RomanLut/Multiwii-ESP32-port/doc/gps_code/gps_code.md

# Abandoned: GPS and compass support

Wiring which has been used in original tests:

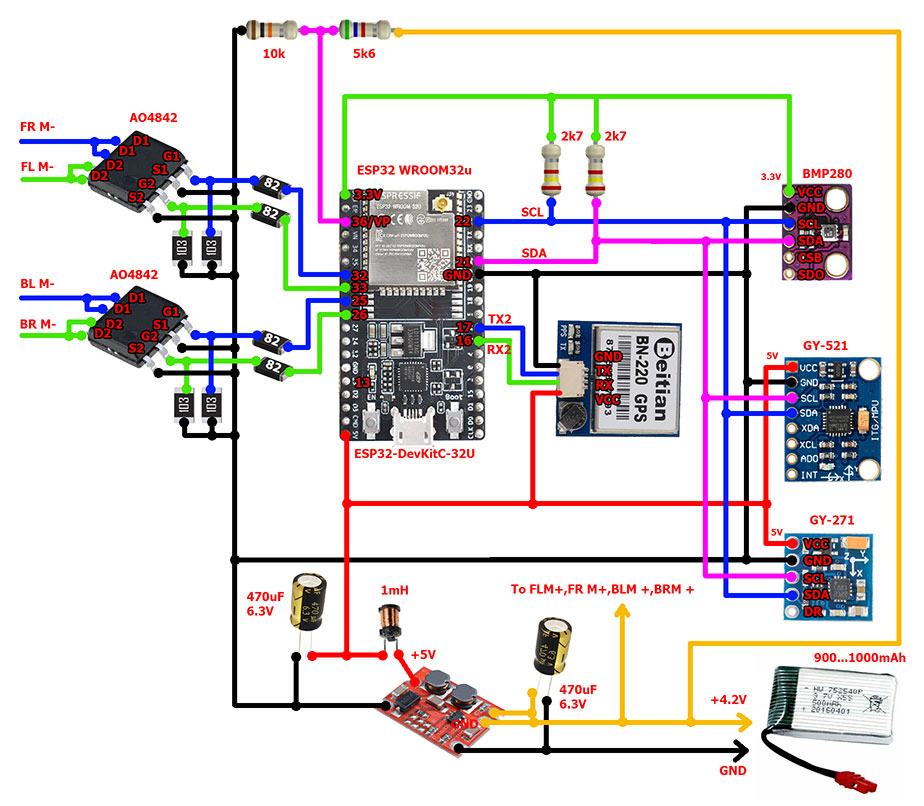
[picture p13: doc/gps_code/wiring.jpg]
wiring


Magnetometer calibration
=========================
Should be done once of each new location
Yaw right + Throttle Hi + Pitch Low
Red and blue leds are blining in circle pattern

At least 30 seconds of calibration.
Rotate quad in all directions. If you do not hear beeps anymore, try another direction of rotation.
Calibration ends when no beeps are heard for 10 seconds.
