RomanLut/Multiwii-ESP32-port/doc/preview.png

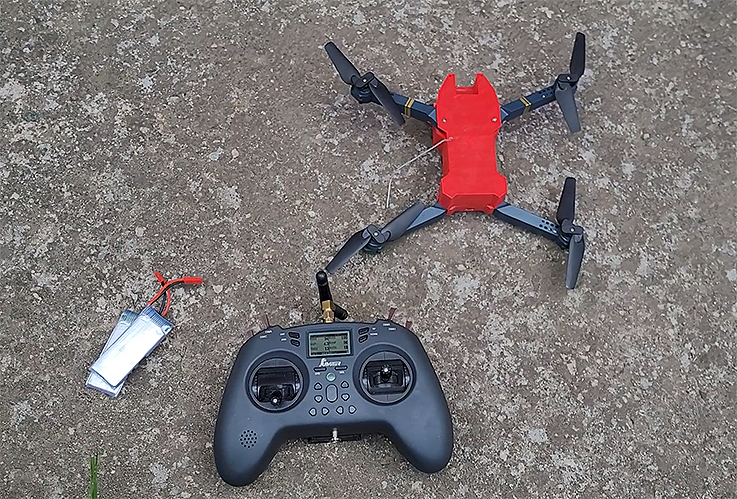
doc/preview.png
