RomanLut/Multiwii-ESP32-port/doc/reference/bmp280.jpg

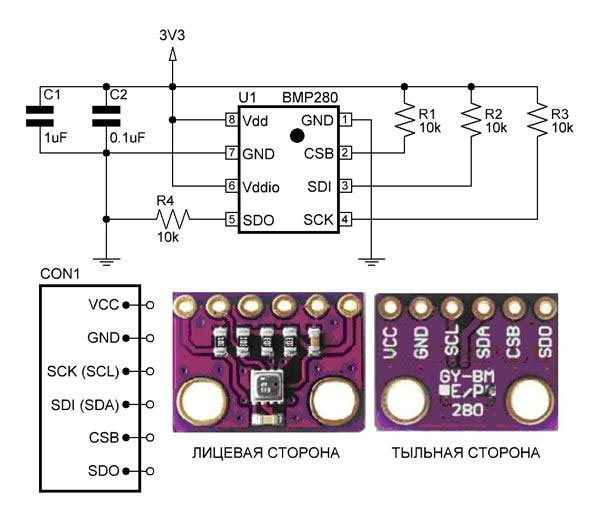
doc/reference/bmp280.jpg
