RomanLut/Multiwii-ESP32-port/doc/reference/esp32_devkitc_wroom32_pinout.jpg

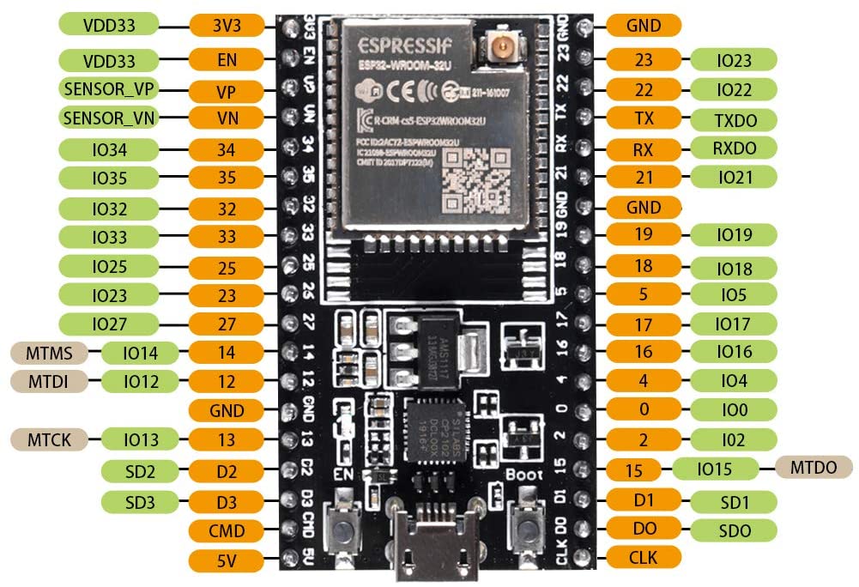
doc/reference/esp32_devkitc_wroom32_pinout.jpg
