RomanLut/Multiwii-ESP32-port/doc/reference/GY521.jpg

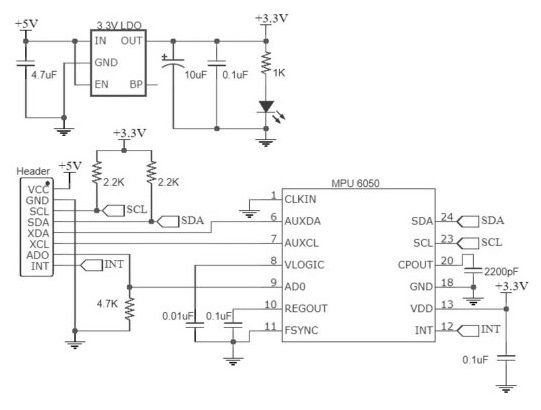
doc/reference/GY521.jpg
