RomanLut/Multiwii-ESP32-port/Drawings/IMG_1333.jpg

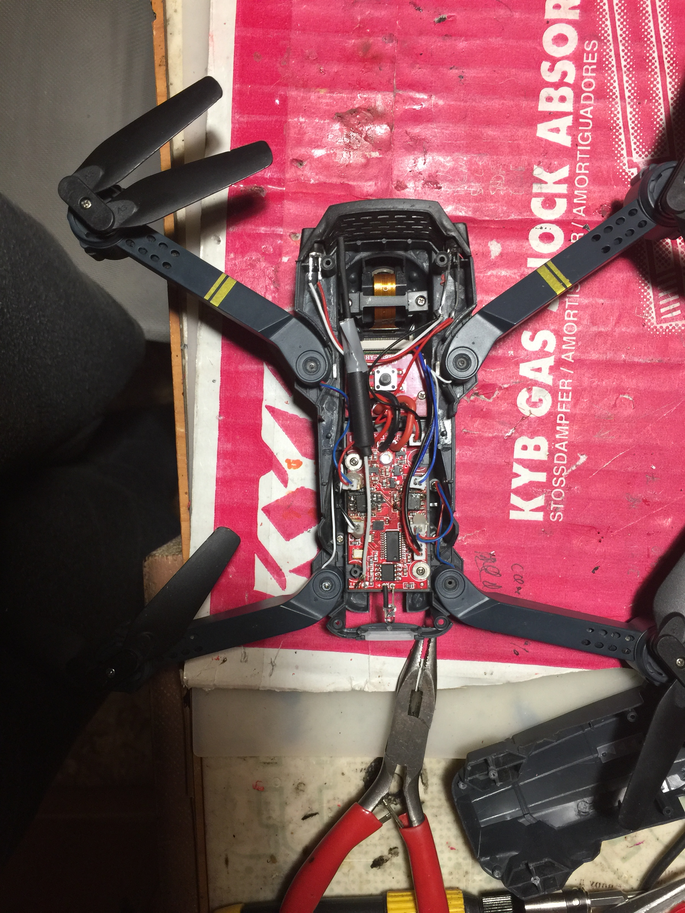
Drawings/IMG_1333.jpg
