RomanLut/Multiwii-ESP32-port/Drawings/quad.SLDASM

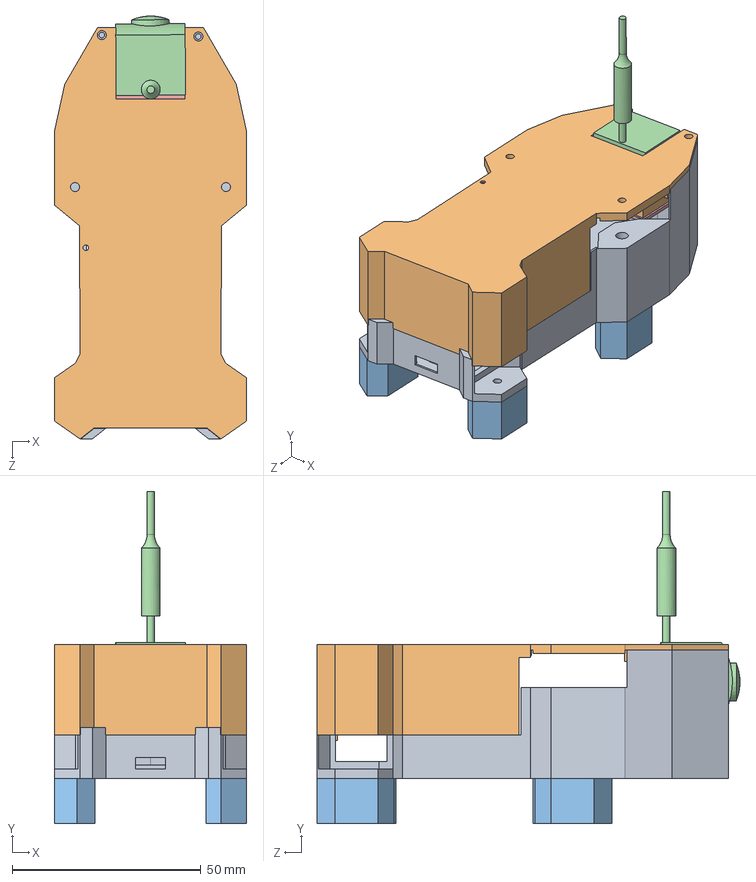
[picture p19: CAD file, 2022-08-13]
Drawings/quad.SLDASM
50.9 x 88.0 x 112.1 mm
Bottom
top
leg x 4
camera_aio
camera_bottom
