RomanLut/Multiwii-ESP32-port/Drawings/top.sldprt

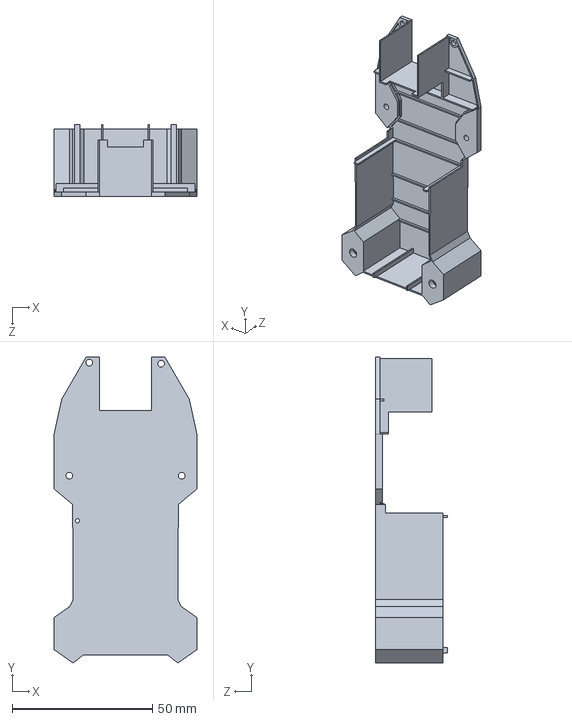
[picture p20: CAD file, 2022-08-13]
Drawings/top.sldprt
50.9 x 109.0 x 25.5 mm
