RomanLut/Multiwii-ESP32-port/Drawings/inset.SLDPRT

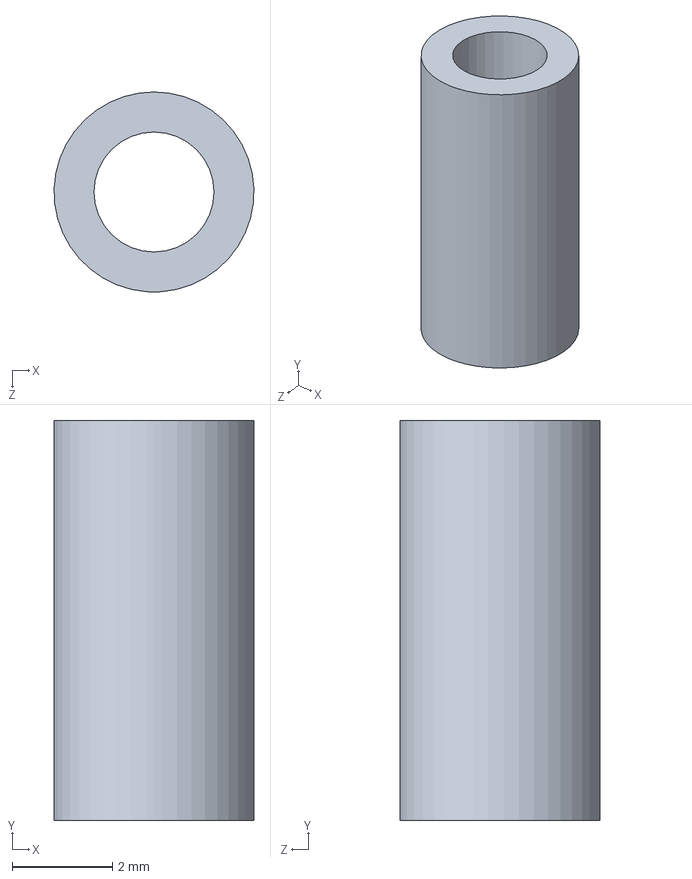
[picture p21: CAD file, 2022-08-13]
Drawings/inset.SLDPRT
4.00 x 8.00 x 4.00 mm
