RomanLut/Multiwii-ESP32-port/Drawings/leg.sldprt

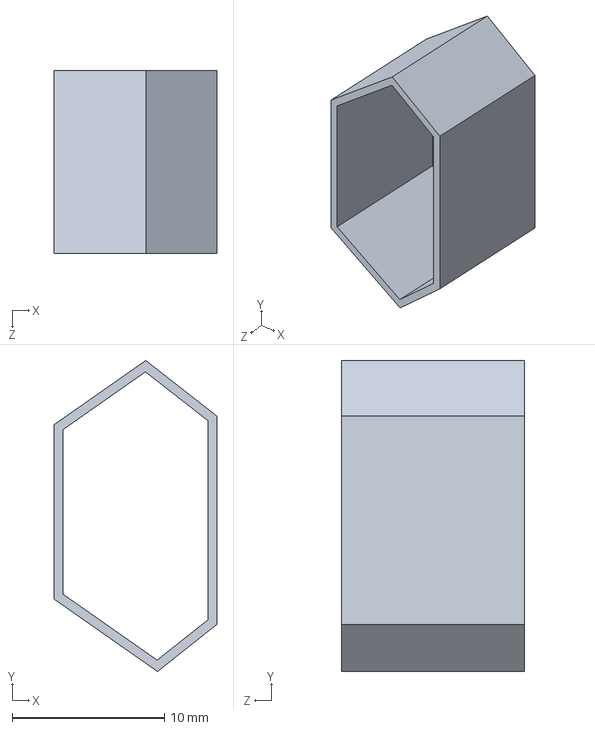
[picture p22: CAD file, 2022-08-13]
Drawings/leg.sldprt
10.7 x 20.4 x 12.0 mm
