RomanLut/Multiwii-ESP32-port/Drawings/ledcap.SLDPRT

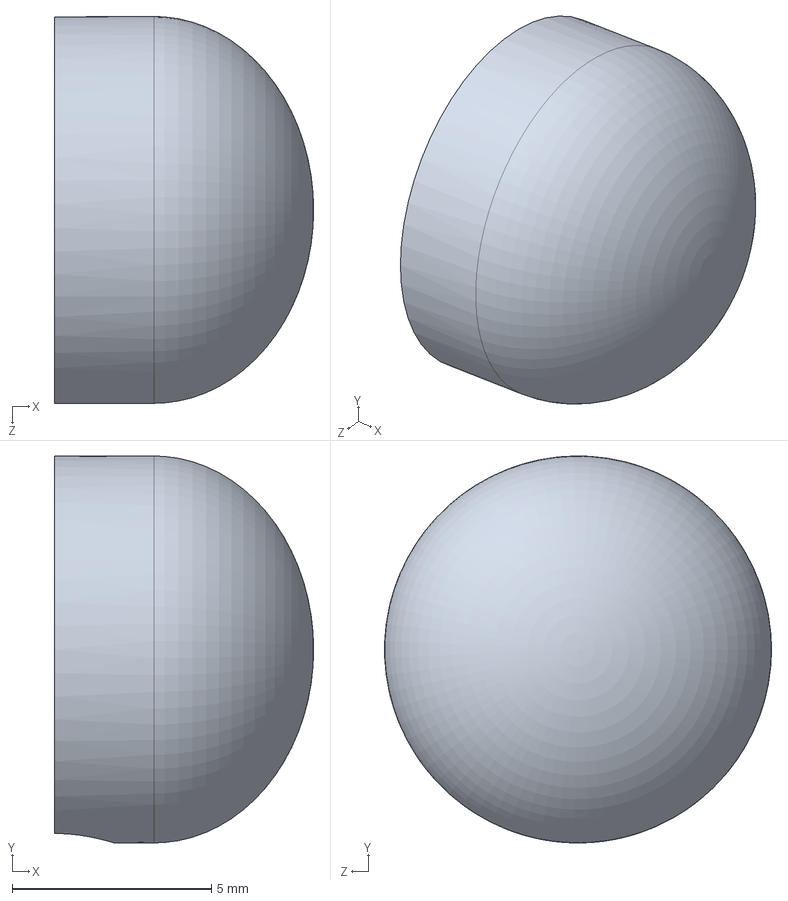
[picture p23: CAD file, 2022-08-13]
Drawings/ledcap.SLDPRT
6.50 x 9.70 x 9.70 mm
