RomanLut/Multiwii-ESP32-port/Drawings/camera_bottom.SLDPRT

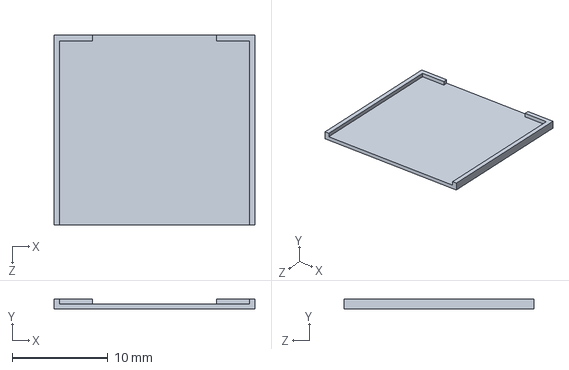
[picture p24: CAD file, 2022-08-13]
Drawings/camera_bottom.SLDPRT
21.0 x 1.00 x 19.8 mm
