RomanLut/Multiwii-ESP32-port/Drawings/camera_aio.SLDPRT

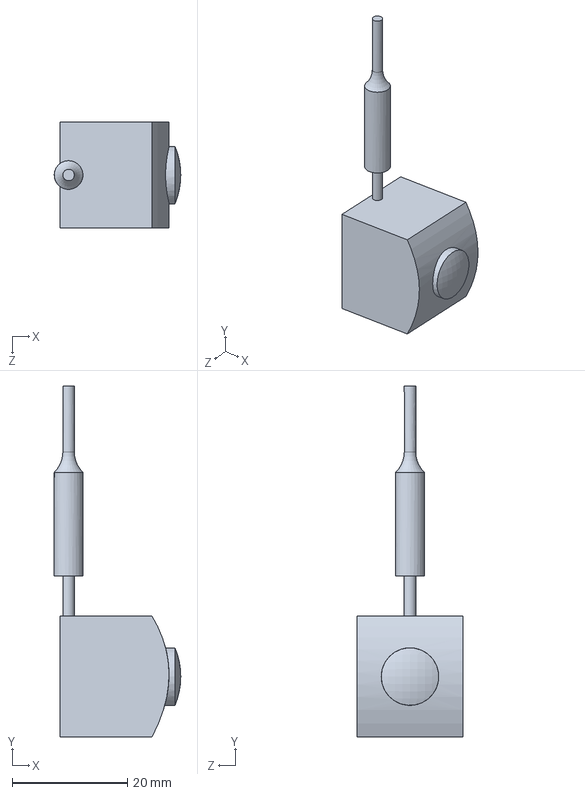
[picture p25: CAD file, 2022-08-13]
Drawings/camera_aio.SLDPRT
22.0 x 61.0 x 18.4 mm
