RomanLut/Multiwii-ESP32-port/Drawings/Bottom.STL

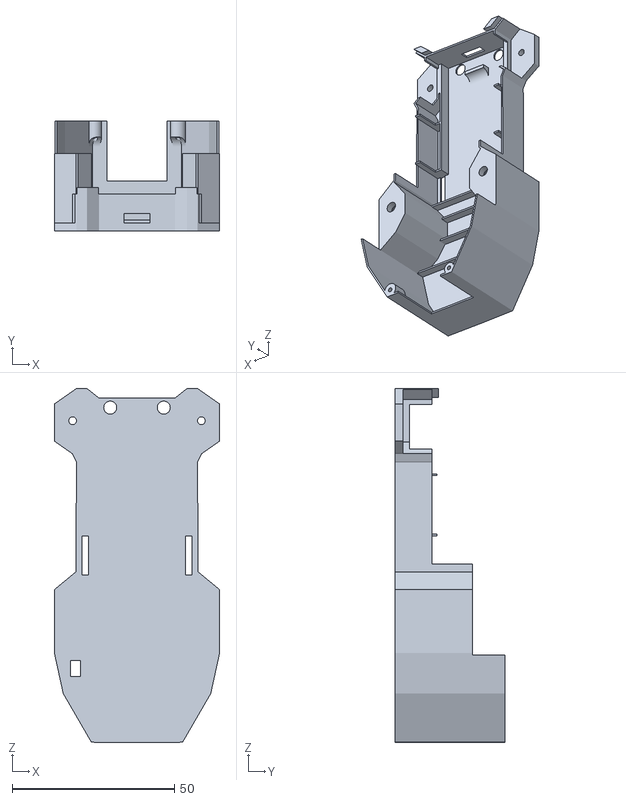
[picture p26: CAD file, 2022-08-13]
Drawings/Bottom.STL
50.9 x 34.0 x 109.1
