RomanLut/Multiwii-ESP32-port/(list of files, cad)

Other CAD files:
Drawings/camera_bottom.STL
Drawings/inset.STL
Drawings/ledcap.STL
Drawings/leg.STL
Drawings/top.STL
