RomanLut/Multiwii-ESP32-port/PlatformIO/src/Sensors.cpp

#ifdef ESP32
#include <Wire.h>
#endif 

#include "Arduino.h"
#include "config.h"
#include "def.h"
#include "types.h"
#include "MahoWii.h"
#include "Alarms.h"
#include "myEEPROM.h"
#include "IMU.h"
#include "LCD.h"
#include "Sensors.h"
#include "AltHold.h"

uint32_t magBeep;

static void Device_Mag_getADC();
static void Baro_init();
static void Mag_init();
static void ACC_init();

// ************************************************************************************************************
// board orientation and setup
// ************************************************************************************************************
//default board orientation
#if !defined(ACC_ORIENTATION)
  #define ACC_ORIENTATION(X, Y, Z)  {imu.accADC[ROLL]  = X; imu.accADC[PITCH]  = Y; imu.accADC[YAW]  = Z;}
#endif
#if !defined(GYRO_ORIENTATION)
  #define GYRO_ORIENTATION(X, Y, Z) {imu.gyroADC[ROLL] = X; imu.gyroADC[PITCH] = Y; imu.gyroADC[YAW] = Z;}
#endif
#if !defined(MAG_ORIENTATION)
  #define MAG_ORIENTATION(X, Y, Z)  {imu.magADC[ROLL]  = X; imu.magADC[PITCH]  = Y; imu.magADC[YAW]  = Z;}
#endif


//ITG3200 / ITG3205 / ITG3050 / MPU6050 / MPU3050 Gyro LPF setting
#if defined(GYRO_LPF_256HZ) || defined(GYRO_LPF_188HZ) || defined(GYRO_LPF_98HZ) || defined(GYRO_LPF_42HZ) || defined(GYRO_LPF_20HZ) || defined(GYRO_LPF_10HZ) || defined(GYRO_LPF_5HZ)
  #if defined(GYRO_LPF_256HZ)
    #define GYRO_DLPF_CFG   0
  #endif
  #if defined(GYRO_LPF_188HZ)
    #define GYRO_DLPF_CFG   1
  #endif
  #if defined(GYRO_LPF_98HZ)
    #define GYRO_DLPF_CFG   2
  #endif
  #if defined(GYRO_LPF_42HZ)
    #define GYRO_DLPF_CFG   3
  #endif
  #if defined(GYRO_LPF_20HZ)
    #define GYRO_DLPF_CFG   4
  #endif
  #if defined(GYRO_LPF_10HZ)
    #define GYRO_DLPF_CFG   5
  #endif
  #if defined(GYRO_LPF_5HZ)
    #define GYRO_DLPF_CFG   6
  #endif
#else
    #define GYRO_DLPF_CFG   4 //Default settings LPF 20HZ
#endif

static uint8_t rawADC[6];
#if defined(WMP)
static uint32_t neutralizeTime = 0;
#endif

// ************************************************************************************************************
// I2C general functions
// ************************************************************************************************************

void i2c_init(void) {
#ifndef ESP32
    #if defined(INTERNAL_I2C_PULLUPS)
      I2C_PULLUPS_ENABLE
    #else
      I2C_PULLUPS_DISABLE
    #endif
    TWSR = 0;                                    // no prescaler => prescaler = 1
    TWBR = ((F_CPU / 400000) - 16) / 2;          // set the I2C clock rate to 400kHz
    TWCR = 1<<TWEN;                              // enable twi module, no interrupt
 #else
      Wire.begin(); //on default pins 21,22
      Wire.setClock(400000);
#endif;
  i2c_errors_count = 0;
}

#ifndef ESP32
void __attribute__ ((noinline)) waitTransmissionI2C(uint8_t twcr) {
  TWCR = twcr;
  uint8_t count = 255;
  while (!(TWCR & (1<<TWINT))) {
    count--;
    if (count==0) {              //we are in a blocking state => we don't insist
      TWCR = 0;                  //and we force a reset on TWINT register
      #if defined(WMP)
      neutralizeTime = micros(); //we take a timestamp here to neutralize the value during a short delay
      #endif
      i2c_errors_count++;
      break;
    }
  }
}

void i2c_rep_start(uint8_t address) {
  waitTransmissionI2C((1<<TWINT) | (1<<TWSTA) | (1<<TWEN)); // send REPEAT START condition and wait until transmission completed
  TWDR = address;                                           // send device address
  waitTransmissionI2C((1<<TWINT) | (1<<TWEN));              // wail until transmission completed
}

void i2c_stop(void) {
  TWCR = (1 << TWINT) | (1 << TWEN) | (1 << TWSTO);
  //  while(TWCR & (1<<TWSTO));                // <- can produce a blocking state with some WMP clones
}

void i2c_write(uint8_t data ) {
  TWDR = data;                                 // send data to the previously addressed device
  waitTransmissionI2C((1<<TWINT) | (1<<TWEN));
}

uint8_t i2c_readAck() {
  waitTransmissionI2C((1<<TWINT) | (1<<TWEN) | (1<<TWEA));
  return TWDR;
}

uint8_t i2c_readNak() {
  waitTransmissionI2C((1<<TWINT) | (1<<TWEN));
  uint8_t r = TWDR;
  i2c_stop();
  return r;
}
#endif

void i2c_read_reg_to_buf(uint8_t add, uint8_t reg, uint8_t *buf, uint8_t size) {
#ifndef ESP32
  i2c_rep_start(add<<1); // I2C write direction
  i2c_write(reg);        // register selection
  i2c_rep_start((add<<1) | 1);  // I2C read direction
  uint8_t *b = buf;
  while (--size) *b++ = i2c_readAck(); // acknowledge all but the final byte
  *b = i2c_readNak();
#else
  Wire.beginTransmission(add);
  Wire.write(reg); 
  int error = Wire.endTransmission(false);
  if ( error != 0 ) i2c_errors_count++;
  int count = Wire.requestFrom((uint16_t)add, size, true);
  if (count != size)
  {
    i2c_errors_count++;
  }
  uint8_t *b = buf;
  if ( count ) while (count-- && size--) *b++ = Wire.read();
#endif
}

void i2c_getSixRawADC(uint8_t add, uint8_t reg) {
  i2c_read_reg_to_buf(add, reg, rawADC, 6);
}

void i2c_writeReg(uint8_t add, uint8_t reg, uint8_t val) {
#ifndef ESP32
  i2c_rep_start(add<<1); // I2C write direction
  i2c_write(reg);        // register selection
  i2c_write(val);        // value to write in register
  i2c_stop();
#else
  Wire.beginTransmission(add);
  Wire.write(reg);
  Wire.write(val);
  int error = Wire.endTransmission(true);
  if (error != 0) i2c_errors_count++;
#endif
}

uint8_t i2c_readReg(uint8_t add, uint8_t reg) {
  uint8_t val;
  i2c_read_reg_to_buf(add, reg, &val, 1);
  return val;
}

// ****************
// GYRO common part
// ****************
void GYRO_Common() {
  static int16_t previousGyroADC[3] = {0,0,0};
  static int32_t g[3];
  uint8_t axis, tilt=0;

  #if defined MMGYRO
    // Moving Average Gyros by Magnetron1
    //---------------------------------------------------
    static int16_t mediaMobileGyroADC[3][MMGYROVECTORLENGTH];
    static int32_t mediaMobileGyroADCSum[3];
    static uint8_t mediaMobileGyroIDX;
    //---------------------------------------------------
  #endif

  if ( calibratingG == 512)
  {
    Serial.println("Calibrating gyro");
  }

	if (calibratingG > 0) {
		for (axis = 0; axis < 3; axis++) {
			if (calibratingG == 512) { // Reset g[axis] at start of calibration
				g[axis] = 0;
#if defined(GYROCALIBRATIONFAILSAFE)
				previousGyroADC[axis] = imu.gyroADC[axis];
			}
			if (calibratingG % 10 == 0) {
				if (abs(imu.gyroADC[axis] - previousGyroADC[axis]) > 8) {
					tilt = 1;
				}
				previousGyroADC[axis] = imu.gyroADC[axis];
#endif
			}
			g[axis] += imu.gyroADC[axis]; // Sum up 512 readings
			//gyroZero[axis] = g[axis] >> 9;
			gyroZero[axis] = g[axis] >> 5; // increase gyro bias precision to 2^(9-5)=16 times
			if (calibratingG == 1) {
				SET_ALARM_BUZZER(ALRM_FAC_CONFIRM, ALRM_LVL_CONFIRM_ELSE);
			}
		}
#if defined(GYROCALIBRATIONFAILSAFE)
		if (tilt) {
			calibratingG = 1000;
      Serial.println("Calibrating gyro failed");
			LEDPIN_ON;
		} else {
			calibratingG--;
      if (calibratingG == 0)
      {
        Serial.println("Calibrating gyro done");
      }
			LEDPIN_OFF;
		}
		return;
#else
		calibratingG--;
#endif
	}

  #ifdef MMGYRO
  mediaMobileGyroIDX = ++mediaMobileGyroIDX % conf.mmgyro;
  for (axis = 0; axis < 3; axis++) {
    //imu.gyroADC[axis]  -= gyroZero[axis];
    imu.gyroADC[axis] = ( (((int32_t)imu.gyroADC[axis]) << 4) - gyroZero[axis]) >> 4; // increase gyro bias precision to 2^(9-5)=16 times
    mediaMobileGyroADCSum[axis] -= mediaMobileGyroADC[axis][mediaMobileGyroIDX];
    //anti gyro glitch, limit the variation between two consecutive readings
    mediaMobileGyroADC[axis][mediaMobileGyroIDX] = constrain(imu.gyroADC[axis],previousGyroADC[axis]-800,previousGyroADC[axis]+800);
    mediaMobileGyroADCSum[axis] += mediaMobileGyroADC[axis][mediaMobileGyroIDX];
    imu.gyroADC[axis] = mediaMobileGyroADCSum[axis] / conf.mmgyro;
  #else
  for (axis = 0; axis < 3; axis++) {
    //imu.gyroADC[axis]  -= gyroZero[axis];
    imu.gyroADC[axis] = ( (((int32_t)imu.gyroADC[axis]) << 4) - gyroZero[axis]) >> 4; // increase gyro bias precision to 2^(9-5)=16 times

    //anti gyro glitch, limit the variation between two consecutive readings
    imu.gyroADC[axis] = constrain(imu.gyroADC[axis],previousGyroADC[axis]-800,previousGyroADC[axis]+800);
  #endif
    previousGyroADC[axis] = imu.gyroADC[axis];
  }

  #if defined(SENSORS_TILT_45DEG_LEFT)
    int16_t temp  = ((imu.gyroADC[PITCH] - imu.gyroADC[ROLL] )*7)/10;
    imu.gyroADC[ROLL] = ((imu.gyroADC[ROLL]  + imu.gyroADC[PITCH])*7)/10;
    imu.gyroADC[PITCH]= temp;
  #endif
  #if defined(SENSORS_TILT_45DEG_RIGHT)
    int16_t temp  = ((imu.gyroADC[PITCH] + imu.gyroADC[ROLL] )*7)/10;
    imu.gyroADC[ROLL] = ((imu.gyroADC[ROLL]  - imu.gyroADC[PITCH])*7)/10;
    imu.gyroADC[PITCH]= temp;
  #endif
}

// ****************
// ACC common part
// ****************
void ACC_Common() {
  static int32_t a[3];
  static uint8_t curAxis = YAW;
  static int16_t limits[3][2] = { {0,0}, {0,0}, {0,0} };

  if (calibratingA > 0) {
        for (uint8_t axis = 0; axis < 3; axis++) {
            // Reset a[axis] at start of calibration
            if (calibratingA == 512) {
                // Find which axis to calibrate?
                int8_t axis2 = (axis + 1) % 3;
                int8_t axis3 = (axis + 2) % 3;
                if ( abs(imu.accADC[axis] - global_conf.accZero[axis]) > abs(imu.accADC[axis2] - global_conf.accZero[axis2])
                		&& abs(imu.accADC[axis] - global_conf.accZero[axis]) > abs(imu.accADC[axis3] - global_conf.accZero[axis3])) {
                    curAxis = axis;
                    global_conf.accZero[curAxis] = 0;
                    global_conf.accScale[curAxis] = 0; // re-calibrate scale, too
                }

                a[axis] = 0;
            }

            // Sum up 512 readings
            a[axis] += imu.accADC[axis];
        }

        // Clear global variables for next reading and indicate curAxis in GUI by set to zero during calibration
        imu.accADC[curAxis] = 0;

        // Calculate average, shift Z down by acc_1G and store values in EEPROM at end of calibration
        if (calibratingA == 1) {
            int8_t curLimit = a[curAxis] > 0 ? 0 : 1; // positive - 0, negative = 1
            limits[curAxis][curLimit] = a[curAxis] >> 9;

            // If we get 2 limits for one axis, we can found precise zero and scale
            if (limits[curAxis][0] > 0 && limits[curAxis][1] < 0) {
                global_conf.accZero[curAxis] = (limits[curAxis][0] + limits[curAxis][1]) / 2;
                global_conf.accScale[curAxis] = ((int32_t) ACC_1G) * 2048 / (limits[curAxis][0] - limits[curAxis][1]);
            }
            // Old (not precise) calibration for Z only
            else if (curAxis == YAW && curLimit == 0) {
                for (uint8_t axis = 0; axis < 3; axis++) {
                    global_conf.accZero[axis] = a[axis] >> 9;
                    if (axis == YAW) {
                        global_conf.accZero[axis] -= ACC_1G;
                    }
                    global_conf.accScale[axis] = 0;
                }
            }

            conf.angleTrim[ROLL] = 0;
            conf.angleTrim[PITCH] = 0;
            writeGlobalSet(1); // write accZero in EEPROM
        }
        calibratingA--;
    }

  /*if (calibratingA>0) {
    calibratingA--;
    for (uint8_t axis = 0; axis < 3; axis++) {
      if (calibratingA == 511) a[axis]=0;   // Reset a[axis] at start of calibration
      a[axis] +=imu.accADC[axis];           // Sum up 512 readings
      global_conf.accZero[axis] = a[axis]>>9; // Calculate average, only the last itteration where (calibratingA == 0) is relevant
    }
    if (calibratingA == 0) {
      global_conf.accZero[YAW] -= ACC_1G;   // shift Z down by ACC_1G and store values in EEPROM at end of calibration
      conf.angleTrim[ROLL]   = 0;
      conf.angleTrim[PITCH]  = 0;
      writeGlobalSet(1); // write accZero in EEPROM
    }
  }*/

  #if defined(INFLIGHT_ACC_CALIBRATION)
      static int32_t b[3];
      static int16_t accZero_saved[3]  = {0,0,0};
      static int16_t  angleTrim_saved[2] = {0, 0};
      //Saving old zeropoints before measurement
      if (InflightcalibratingA==50) {
         accZero_saved[ROLL]  = global_conf.accZero[ROLL] ;
         accZero_saved[PITCH] = global_conf.accZero[PITCH];
         accZero_saved[YAW]   = global_conf.accZero[YAW] ;
         angleTrim_saved[ROLL]  = conf.angleTrim[ROLL] ;
         angleTrim_saved[PITCH] = conf.angleTrim[PITCH] ;
      }
      if (InflightcalibratingA>0) {
        for (uint8_t axis = 0; axis < 3; axis++) {
          // Reset a[axis] at start of calibration
          if (InflightcalibratingA == 50) b[axis]=0;
          // Sum up 50 readings
          b[axis] +=imu.accADC[axis];
          // Clear global variables for next reading
          imu.accADC[axis]=0;
          global_conf.accZero[axis]=0;
        }
        //all values are measured
        if (InflightcalibratingA == 1) {
          AccInflightCalibrationActive = 0;
          AccInflightCalibrationMeasurementDone = 1;
          SET_ALARM_BUZZER(ALRM_FAC_CONFIRM, ALRM_LVL_CONFIRM_1);     //buzzer for indicatiing the end of calibration
          // recover saved values to maintain current flight behavior until new values are transferred
          global_conf.accZero[ROLL]  = accZero_saved[ROLL] ;
          global_conf.accZero[PITCH] = accZero_saved[PITCH];
          global_conf.accZero[YAW]   = accZero_saved[YAW] ;
          conf.angleTrim[ROLL]  = angleTrim_saved[ROLL] ;
          conf.angleTrim[PITCH] = angleTrim_saved[PITCH] ;
        }
        InflightcalibratingA--;
      }
      // Calculate average, shift Z down by ACC_1G and store values in EEPROM at end of calibration
      if (AccInflightCalibrationSavetoEEProm == 1){  //the copter is landed, disarmed and the combo has been done again
        AccInflightCalibrationSavetoEEProm = 0;
        global_conf.accZero[ROLL]  = b[ROLL]/50;
        global_conf.accZero[PITCH] = b[PITCH]/50;
        global_conf.accZero[YAW]   = b[YAW]/50-ACC_1G;
        conf.angleTrim[ROLL]   = 0;
        conf.angleTrim[PITCH]  = 0;
        writeGlobalSet(1); // write accZero in EEPROM
      }
  #endif

//  imu.accADC[ROLL]  -=  global_conf.accZero[ROLL] ;
//  imu.accADC[PITCH] -=  global_conf.accZero[PITCH];
//  imu.accADC[YAW]   -=  global_conf.accZero[YAW] ;

  // Calibrate
    for (uint8_t axis = 0; axis < 3; axis++) {
        if (global_conf.accScale[axis]) {
            //imu.accADC[axis] = ((int32_t) (imu.accADC[axis] - global_conf.accZero[axis])) * global_conf.accScale[axis] / 1024;
            imu.accADC[axis] = (((int32_t) (imu.accADC[axis] - global_conf.accZero[axis])) * global_conf.accScale[axis]) >> 10; // divide by 1024
        } else {
            imu.accADC[axis] -= global_conf.accZero[axis];
        }
    }

  #if defined(SENSORS_TILT_45DEG_LEFT)
    int16_t temp = ((imu.accADC[PITCH] - imu.accADC[ROLL] )*7)/10;
    imu.accADC[ROLL] = ((imu.accADC[ROLL]  + imu.accADC[PITCH])*7)/10;
    imu.accADC[PITCH] = temp;
  #endif
  #if defined(SENSORS_TILT_45DEG_RIGHT)
    int16_t temp = ((imu.accADC[PITCH] + imu.accADC[ROLL] )*7)/10;
    imu.accADC[ROLL] = ((imu.accADC[ROLL]  - imu.accADC[PITCH])*7)/10;
    imu.accADC[PITCH] = temp;
  #endif
}

// ************************************************************************************************************
// BARO section
// ************************************************************************************************************
#if BARO

#define BARO_TAB_SIZE   21

static void Baro_Common() {
  static int32_t baroHistTab[BARO_TAB_SIZE];
  static uint8_t baroHistIdx;

  uint8_t indexplus1 = (baroHistIdx + 1);
  if (indexplus1 == BARO_TAB_SIZE) indexplus1 = 0;
  baroHistTab[baroHistIdx] = baroPressure;
  baroPressureSum += baroHistTab[baroHistIdx];
  baroPressureSum -= baroHistTab[indexplus1];
  baroHistIdx = indexplus1;
}

#endif

// ************************************************************************************************************
// I2C Barometer BOSCH BMP085
// ************************************************************************************************************
// I2C adress: 0x77 (7bit)
// principle:
//  1) read the calibration register (only once at the initialization)
//  2) read uncompensated temperature (not mandatory at every cycle)
//  3) read uncompensated pressure
//  4) raw temp + raw pressure => calculation of the adjusted pressure
//  the following code uses the maximum precision setting (oversampling setting 3)
// ************************************************************************************************************

#if defined(BMP085)
#define BMP085_ADDRESS 0x77

static struct {
  // sensor registers from the BOSCH BMP085 datasheet
  int16_t  ac1, ac2, ac3;
  uint16_t ac4, ac5, ac6;
  int16_t  b1, b2, mb, mc, md;
  union {uint16_t val; uint8_t raw[2]; } ut; //uncompensated T
  union {uint32_t val; uint8_t raw[4]; } up; //uncompensated P
  uint8_t  state;
  uint32_t deadline;
} bmp085_ctx;
#define OSS 3

/* transform a series of bytes from big endian to little
   endian and vice versa. */
void swap_endianness(void *buf, size_t size) {
  /* we swap in-place, so we only have to
  * place _one_ element on a temporary tray
  */
  uint8_t tray;
  uint8_t *from;
  uint8_t *to;
  /* keep swapping until the pointers have assed each other */
  for (from = (uint8_t*)buf, to = &from[size-1]; from < to; from++, to--) {
    tray = *from;
    *from = *to;
    *to = tray;
  }
}

void i2c_BMP085_readCalibration(){
  delay(10);
  //read calibration data in one go
  size_t s_bytes = (uint8_t*)&bmp085_ctx.md - (uint8_t*)&bmp085_ctx.ac1 + sizeof(bmp085_ctx.ac1);
  i2c_read_reg_to_buf(BMP085_ADDRESS, 0xAA, (uint8_t*)&bmp085_ctx.ac1, s_bytes);
  // now fix endianness
  int16_t *p;
  for (p = &bmp085_ctx.ac1; p <= &bmp085_ctx.md; p++) {
    swap_endianness(p, sizeof(*p));
  }
}

// read uncompensated temperature value: send command first
void i2c_BMP085_UT_Start(void) {
  i2c_writeReg(BMP085_ADDRESS, 0xf4, 0x2e);
#ifndef ESP32
  i2c_rep_start(BMP085_ADDRESS<<1);
  i2c_write(0xF6);
  i2c_stop();
#else
  Wire.beginTransmission(BMP085_ADDRESS);
  Wire.write(0xF6);
  int error = Wire.endTransmission(false);
  if (error != 0) i2c_errors_count++;
#endif
}

// read uncompensated pressure value: send command first
void i2c_BMP085_UP_Start () {
  i2c_writeReg(BMP085_ADDRESS, 0xf4, 0x34 + (OSS << 6)); // control register value for oversampling setting 3
#ifndef ESP32
  i2c_rep_start(BMP085_ADDRESS<<1); //I2C write direction => 0
  i2c_write(0xF6);
  i2c_stop();
#else
  Wire.beginTransmission(BMP085_ADDRESS);
  Wire.write(0xF6);
  int error = Wire.endTransmission(false);
  if (error != 0) i2c_errors_count++;
#endif
}

// read uncompensated pressure value: read result bytes
// the datasheet suggests a delay of 25.5 ms (oversampling settings 3) after the send command
void i2c_BMP085_UP_Read () {
#ifndef ESP32
  i2c_rep_start((BMP085_ADDRESS<<1) | 1);//I2C read direction => 1
  bmp085_ctx.up.raw[2] = i2c_readAck();
  bmp085_ctx.up.raw[1] = i2c_readAck();
  bmp085_ctx.up.raw[0] = i2c_readNak();
#else
  int count = Wire.requestFrom((uint16_t)BMP085_ADDRESS, (uint8_t)3, true);
  if (count != 3)
  {
    i2c_errors_count++;
  }
  if (count) { count--; bmp085_ctx.up.raw[2] = Wire.read(); }
  if (count) { count--; bmp085_ctx.up.raw[1] = Wire.read(); }
  if (count) { count--; bmp085_ctx.up.raw[0] = Wire.read(); }
#endif
}

// read uncompensated temperature value: read result bytes
// the datasheet suggests a delay of 4.5 ms after the send command
void i2c_BMP085_UT_Read() {
#ifndef ESP32
  i2c_rep_start((BMP085_ADDRESS<<1) | 1);//I2C read direction => 1
  bmp085_ctx.ut.raw[1] = i2c_readAck();
  bmp085_ctx.ut.raw[0] = i2c_readNak();
#else
  int count = Wire.requestFrom((uint16_t)BMP085_ADDRESS, (uint8_t)2, true);
  if (count != 2)
  {
    i2c_errors_count++;
  }
  if (count) { count--; bmp085_ctx.ut.raw[1] = Wire.read(); }
  if (count) { count--; bmp085_ctx.ut.raw[0] = Wire.read(); }
#endif
}

void i2c_BMP085_Calculate() {
  int32_t  x1, x2, x3, b3, b5, b6, p, tmp;
  uint32_t b4, b7;
  // Temperature calculations
  x1 = ((int32_t)bmp085_ctx.ut.val - bmp085_ctx.ac6) * bmp085_ctx.ac5 >> 15;
  x2 = ((int32_t)bmp085_ctx.mc << 11) / (x1 + bmp085_ctx.md);
  b5 = x1 + x2;
  baroTemperature = (b5 * 10 + 8) >> 4; // in 0.01 degC (same as MS561101BA temperature)
  // Pressure calculations
  b6 = b5 - 4000;
  x1 = (bmp085_ctx.b2 * (b6 * b6 >> 12)) >> 11;
  x2 = bmp085_ctx.ac2 * b6 >> 11;
  x3 = x1 + x2;
  tmp = bmp085_ctx.ac1;
  tmp = (tmp*4 + x3) << OSS;
  b3 = (tmp+2)/4;
  x1 = bmp085_ctx.ac3 * b6 >> 13;
  x2 = (bmp085_ctx.b1 * (b6 * b6 >> 12)) >> 16;
  x3 = ((x1 + x2) + 2) >> 2;
  b4 = (bmp085_ctx.ac4 * (uint32_t)(x3 + 32768)) >> 15;
  b7 = ((uint32_t) (bmp085_ctx.up.val >> (8-OSS)) - b3) * (50000 >> OSS);
  p = b7 < 0x80000000 ? (b7 * 2) / b4 : (b7 / b4) * 2;
  x1 = (p >> 8) * (p >> 8);
  x1 = (x1 * 3038) >> 16;
  x2 = (-7357 * p) >> 16;
  baroPressure = p + ((x1 + x2 + 3791) >> 4);
}

void  Baro_init() {
  delay(10);
  i2c_BMP085_readCalibration();
  delay(5);
  i2c_BMP085_UT_Start();
  bmp085_ctx.deadline = currentTime+5000;
}

//return 0: no data available, no computation ;  1: new value available  ; 2: no new value, but computation time
uint8_t Baro_update() {                   // first UT conversion is started in init procedure
  if (currentTime < bmp085_ctx.deadline) return 0;
  bmp085_ctx.deadline = currentTime+6000; // 1.5ms margin according to the spec (4.5ms T convetion time)
  if (bmp085_ctx.state == 0) {
    i2c_BMP085_UT_Read();
    i2c_BMP085_UP_Start();
    bmp085_ctx.state = 1;
    Baro_Common();
    bmp085_ctx.deadline += 21000;   // 6000+21000=27000 1.5ms margin according to the spec (25.5ms P convetion time with OSS=3)
    return 1;
  } else {
    i2c_BMP085_UP_Read();
    i2c_BMP085_UT_Start();
    i2c_BMP085_Calculate();
    bmp085_ctx.state = 0;
    return 2;
  }
}
#endif


// ************************************************************************************************************
// I2C Barometer BOSCH BMP280
// ************************************************************************************************************
// I2C adress: 0x76 or 0x77 !!!Please make sure you set the correct address (BMP280_ADDR)
// As any other I2C device, the BMP280 sensor has an I2C slave address which is 0x76 or 0x77.
// This address depends on the connection of the SDO pin(used for SPI mode as serial data out or MISO),
// if the SDO pin is connected(directly or through resistor) to VCC(3.3V) the address will be 0x77,
// and if it’s connected to GND the address will be 0x76.
// ************************************************************************************************************

#if defined(BMP280)

#define BMP280_ADDR  0x76 
//#define i2c_read(ack)  (ack) ? i2c_readAck() : i2c_readNak(); 

#define BMP280_CAL_REG_FIRST  0x88
#define BMP280_CAL_REGS 12
#define BMP280_CAL_DATA_SIZE  (BMP280_CAL_REGS*2)

#define BMP280_STATUS_REG 0xF3
#define BMP280_CONTROL_REG  0xF4
#define BMP280_CONFIG_REG 0xF5

#define BMP280_PRES_REG   0xF7
#define BMP280_TEMP_REG   0xFA
#define BMP280_RAWDATA_BYTES  6 // 3 bytes pressure, 3 bytes temperature

int64_t p; //temp variable for calculating pressure  
uint32_t deadline;

#pragma pack(push,1)
static union _bmp280_cal_union
{
  uint8_t bytes[BMP280_CAL_DATA_SIZE];
  struct
  {
    uint16_t dig_t1;
    int16_t  dig_t2;
    int16_t  dig_t3;
    uint16_t dig_p1;
    int16_t  dig_p2;
    int16_t  dig_p3;
    int16_t  dig_p4;
    int16_t  dig_p5;
    int16_t  dig_p6;
    int16_t  dig_p7;
    int16_t  dig_p8;
    int16_t  dig_p9;
  };
} bmp280_cal;
#pragma pack(pop)

/*
 * read calibration registers
 */
static void bmp280_getcalibration(void)
{
  memset(bmp280_cal.bytes, 0, sizeof(bmp280_cal));

  i2c_read_reg_to_buf(BMP280_ADDR,
    BMP280_CAL_REG_FIRST,
    bmp280_cal.bytes,
    BMP280_CAL_DATA_SIZE
  );
}

void bmp280_set_ctrl(uint8_t osrs_t, uint8_t osrs_p, uint8_t mode)
{
  i2c_writeReg(BMP280_ADDR, BMP280_CONTROL_REG,
    ((osrs_t & 0x7) << 5) | ((osrs_p & 0x7) << 2) | (mode & 0x3));
}

void bmp280_set_config(uint8_t t_sb, uint8_t filter, uint8_t spi3w_en)
{
  i2c_writeReg(BMP280_ADDR, BMP280_CONFIG_REG,
    ((t_sb & 0x7) << 5) | ((filter & 0x7) << 2) | (spi3w_en & 1));
}

#define bmp280_24bit_reg(b1, b2, b3)  ( \
  ((int32_t)(b1) << 16) \
  | ((int32_t)(b2) << 8) \
  | ((int32_t)(b3) ) \
)

/*  Measures and calculates pressure and temperature
 *
 *  This function updates global variables baroPressure and baroTemperature
 *
 *  baroTemperature unit is 0.01 deg C
 *  baroPressure unit is Pa
 *
 */


void bmp280_measure(void)
{
  uint8_t data[BMP280_RAWDATA_BYTES];
  int32_t temp_raw, pres_raw;
  int64_t var1, var2, t_fine;
  i2c_read_reg_to_buf(BMP280_ADDR, BMP280_PRES_REG, data, BMP280_RAWDATA_BYTES);
  pres_raw = bmp280_24bit_reg(data[0], data[1], data[2]);
  temp_raw = bmp280_24bit_reg(data[3], data[4], data[5]);

  temp_raw >>= 4;   //20 bits
  pres_raw >>= 4;   //20 bits

  var1 = ((((temp_raw >> 3) - ((int32_t)bmp280_cal.dig_t1 << 1))) *
    ((int32_t)bmp280_cal.dig_t2)) >> 11;

  var2 = (((((temp_raw >> 4) - ((int32_t)bmp280_cal.dig_t1)) *
    ((temp_raw >> 4) - ((int32_t)bmp280_cal.dig_t1))) >> 12) *
    ((int32_t)bmp280_cal.dig_t3)) >> 14;

  t_fine = var1 + var2;

  // temperature in DegC, resolution is 0.01 DegC. Output value of "5123" equals 51.23 DegC
  baroTemperature = (t_fine * 5 + 128) >> 8;

  var1 = ((int64_t)t_fine) - 128000;
  var2 = var1 * var1 * (int64_t)bmp280_cal.dig_p6;
  var2 = var2 + ((var1 * (int64_t)bmp280_cal.dig_p5) << 17);
  var2 = var2 + (((int64_t)bmp280_cal.dig_p4) << 35);
  var1 = ((var1 * var1 * (int64_t)bmp280_cal.dig_p3) >> 8) +
    ((var1 * (int64_t)bmp280_cal.dig_p2) << 12);
  var1 = (((((int64_t)1) << 47) + var1)) * ((int64_t)bmp280_cal.dig_p1) >> 33;

  if (var1 == 0)
  {
    return; // avoid exception caused by division by zero
  }
  p = 1048576 - pres_raw;
  p = (((p << 31) - var2) * 3125) / var1;
  var1 = (((int64_t)bmp280_cal.dig_p9) * (p >> 13) * (p >> 13)) >> 25;
  var2 = (((int64_t)bmp280_cal.dig_p8) * p) >> 19;

  p = ((p + var1 + var2) >> 8) + (((int64_t)bmp280_cal.dig_p7) << 4);
  baroPressure = (p + 128) >> 8; //baroPressure in Pa
}

void  Baro_init()
{
  bmp280_getcalibration();
  bmp280_set_config(0, 4, 0); // 0.5 ms standby time, 16x filter, no 3-wire SPI
  bmp280_set_ctrl(2, 5, 3); // T oversample x2, P over sample x16, normal mode
  deadline = currentTime + 5000;
}

//return 0: no data available, no computation ;  1: new value available and computation ; 
uint8_t Baro_update()
{
  if (currentTime < deadline) return 0;
  deadline = currentTime + 3000;

  Baro_Common();
  bmp280_measure();

  return 1;
}
#endif

// ************************************************************************************************************
// I2C Barometer MS561101BA
// ************************************************************************************************************
//
// specs are here: http://www.meas-spec.com/downloads/MS5611-01BA03.pdf
// useful info on pages 7 -> 12
#if defined(MS561101BA)
#if !defined(MS561101BA_ADDRESS)
  #define MS561101BA_ADDRESS 0x77 //CBR=0 0xEE I2C address when pin CSB is connected to LOW (GND)
  //#define MS561101BA_ADDRESS 0x76 //CBR=1 0xEC I2C address when pin CSB is connected to HIGH (VCC)
#endif

// registers of the device
#define MS561101BA_PRESSURE    0x40
#define MS561101BA_TEMPERATURE 0x50
#define MS561101BA_RESET       0x1E

// OSR (Over Sampling Ratio) constants
#define MS561101BA_OSR_256  0x00
#define MS561101BA_OSR_512  0x02
#define MS561101BA_OSR_1024 0x04
#define MS561101BA_OSR_2048 0x06
#define MS561101BA_OSR_4096 0x08

#define OSR MS561101BA_OSR_4096

static struct {
  // sensor registers from the MS561101BA datasheet
  uint16_t c[7];
  uint32_t ut; //uncompensated T
  uint32_t up; //uncompensated P
  uint8_t  state;
  uint16_t deadline;
} ms561101ba_ctx;

static void Baro_init() {
  //reset
  i2c_writeReg(MS561101BA_ADDRESS, MS561101BA_RESET, 0);
  delay(100);

  //read calibration data
  union {uint16_t val; uint8_t raw[2]; } data;
  for(uint8_t i=0;i<6;i++) {
    i2c_rep_start(MS561101BA_ADDRESS<<1);
    i2c_write(0xA2+2*i);
    i2c_rep_start((MS561101BA_ADDRESS<<1) | 1);//I2C read direction => 1
    data.raw[1] = i2c_readAck();  // read a 16 bit register
    data.raw[0] = i2c_readNak();
    ms561101ba_ctx.c[i+1] = data.val;
  }
}

// read uncompensated temperature or pressure value: send command first
static void i2c_MS561101BA_UT_or_UP_Start(uint8_t reg) {
  i2c_rep_start(MS561101BA_ADDRESS<<1);     // I2C write direction
  i2c_write(reg);  // register selection
  i2c_stop();
}

static void i2c_MS561101BA_UT_or_UP_Read(uint32_t* val) {
  union {uint32_t val; uint8_t raw[4]; } data;
  i2c_rep_start(MS561101BA_ADDRESS<<1);
  i2c_write(0);
  i2c_rep_start((MS561101BA_ADDRESS<<1) | 1);
  data.raw[2] = i2c_readAck();
  data.raw[1] = i2c_readAck();
  data.raw[0] = i2c_readNak();
  *val = data.val;
}

// use float approximation instead of int64_t intermediate values
// does not use 2nd order compensation under -15 deg
static void i2c_MS561101BA_Calculate() {
  int32_t delt;

  float dT        = (int32_t)ms561101ba_ctx.ut - (int32_t)((uint32_t)ms561101ba_ctx.c[5] << 8);
  float off       = ((uint32_t)ms561101ba_ctx.c[2] <<16) + ((dT * ms561101ba_ctx.c[4]) /((uint32_t)1<<7));
  float sens      = ((uint32_t)ms561101ba_ctx.c[1] <<15) + ((dT * ms561101ba_ctx.c[3]) /((uint32_t)1<<8));
  delt            = (dT * ms561101ba_ctx.c[6])/((uint32_t)1<<23);
  baroTemperature = delt + 2000;
  if (delt < 0) { // temperature lower than 20st.C
    delt *= 5 * delt;
    off  -= delt>>1;
    sens -= delt>>2;
  }
  baroPressure     = (( (ms561101ba_ctx.up * sens ) /((uint32_t)1<<21)) - off)/((uint32_t)1<<15);
}

//return 0: no data available, no computation ;  1: new value available   or   no new value but computation time
uint8_t Baro_update() {                          // first UT conversion is started in init procedure
  uint32_t* rawValPointer;
  uint8_t   commandRegister;

  if (ms561101ba_ctx.state == 2) {               // a third state is introduced here to isolate calculate() and smooth timecycle spike
    ms561101ba_ctx.state = 0;
    i2c_MS561101BA_Calculate();
    return 1;
  }
  if ((int16_t)(currentTime - ms561101ba_ctx.deadline)<0) return 0; // the initial timer is not initialized, but in any case, no more than 65ms to wait.
  ms561101ba_ctx.deadline = currentTime+10000;  // UT and UP conversion take 8.5ms so we do next reading after 10ms
  if (ms561101ba_ctx.state == 0) {
    Baro_Common();                              // moved here for less timecycle spike, goes after i2c_MS561101BA_Calculate
    rawValPointer = &ms561101ba_ctx.ut;
    commandRegister = MS561101BA_PRESSURE + OSR;
  } else {
    rawValPointer = &ms561101ba_ctx.up;
    commandRegister = MS561101BA_TEMPERATURE + OSR;
  }
  ms561101ba_ctx.state++;
  i2c_MS561101BA_UT_or_UP_Read(rawValPointer);     // get the 24bit resulting from a UP of UT command request. Nothing interresting for the first cycle because we don't initiate a command in Baro_init()
  i2c_MS561101BA_UT_or_UP_Start(commandRegister);  // send the next command to get UP or UT value after at least 8.5ms
  return 1;
}
#endif

// ************************************************************************************************************
// I2C Accelerometer MMA7455
// ************************************************************************************************************
#if defined(MMA7455)
#if !defined(MMA7455_ADDRESS)
  #define MMA7455_ADDRESS 0x1D
#endif

void ACC_init () {
  delay(10);
  i2c_writeReg(MMA7455_ADDRESS,0x16,0x21);
}

void ACC_getADC () {
  i2c_getSixRawADC(MMA7455_ADDRESS,0x00);

  ACC_ORIENTATION((int16_t)((rawADC[1]<<8) | int8_t(rawADC[0])) ,
    (int16_t)((rawADC[3]<<8) | int8_t(rawADC[2])) ,
    (int16_t)((rawADC[5]<<8) | int8_t(rawADC[4])) );
  ACC_Common();
}
#endif

// ************************************************************************************************************
// I2C Accelerometer MMA8451Q
// ************************************************************************************************************
#if defined(MMA8451Q)

#if !defined(MMA8451Q_ADDRESS)
  #define MMA8451Q_ADDRESS 0x1C
  //#define MMA8451Q_ADDRESS 0x1D
#endif

void ACC_init () {
  delay(10);
  i2c_writeReg(MMA8451Q_ADDRESS,0x2A,0x05); // wake up & low noise
  delay(10);
  i2c_writeReg(MMA8451Q_ADDRESS,0x0E,0x02); // full scale range
}

void ACC_getADC () {
  i2c_getSixRawADC(MMA8451Q_ADDRESS,0x00);

  ACC_ORIENTATION((int16_t)((rawADC[1]<<8) | rawADC[0])/32 ,
    (int16_t)((rawADC[3]<<8) | rawADC[2])/32 ,
    (int16_t)((rawADC[5]<<8) | rawADC[4])/32);
  ACC_Common();
}
#endif

// ************************************************************************************************************
// I2C Accelerometer ADXL345
// ************************************************************************************************************
// I2C adress: 0x3A (8bit)    0x1D (7bit)
// Resolution: 10bit (Full range - 14bit, but this is autoscaling 10bit ADC to the range +- 16g)
// principle:
//  1) CS PIN must be linked to VCC to select the I2C mode
//  2) SD0 PIN must be linked to VCC to select the right I2C adress
//  3) bit  b00000100 must be set on register 0x2D to read data (only once at the initialization)
//  4) bits b00001011 must be set on register 0x31 to select the data format (only once at the initialization)
// ************************************************************************************************************
#if defined(ADXL345)
#if !defined(ADXL345_ADDRESS)
  #define ADXL345_ADDRESS 0x1D
  //#define ADXL345_ADDRESS 0x53   //WARNING: Conflicts with a Wii Motion plus!
#endif

void ACC_init () {
  delay(10);
  i2c_writeReg(ADXL345_ADDRESS,0x2D,1<<3); //  register: Power CTRL  -- value: Set measure bit 3 on
  i2c_writeReg(ADXL345_ADDRESS,0x31,0x0B); //  register: DATA_FORMAT -- value: Set bits 3(full range) and 1 0 on (+/- 16g-range)
  i2c_writeReg(ADXL345_ADDRESS,0x2C,0x09); //  register: BW_RATE     -- value: rate=50hz, bw=20hz
}

void ACC_getADC () {
  i2c_getSixRawADC(ADXL345_ADDRESS,0x32);

  ACC_ORIENTATION((int16_t)((rawADC[1]<<8) | rawADC[0]) ,
    (int16_t)((rawADC[3]<<8) | rawADC[2]) ,
    (int16_t)((rawADC[5]<<8) | rawADC[4]) );
  ACC_Common();
}
#endif

// ************************************************************************************************************
// I2C Accelerometer BMA180
// ************************************************************************************************************
// I2C adress: 0x80 (8bit)    0x40 (7bit) (SDO connection to VCC)
// I2C adress: 0x82 (8bit)    0x41 (7bit) (SDO connection to VDDIO)
// Resolution: 14bit
//
// Control registers:
//
// 0x20    bw_tcs:      |                                           bw<3:0> |                        tcs<3:0> |
//                      |                                             150Hz |                        xxxxxxxx |
// 0x30    tco_z:       |                                                tco_z<5:0>    |     mode_config<1:0> |
//                      |                                                xxxxxxxxxx    |                   00 |
// 0x35    offset_lsb1: |          offset_x<3:0>              |                   range<2:0>       | smp_skip |
//                      |          xxxxxxxxxxxxx              |                    8G:   101       | xxxxxxxx |
// ************************************************************************************************************
#if defined(BMA180)
#if !defined(BMA180_ADDRESS)
  #define BMA180_ADDRESS 0x40
  //#define BMA180_ADDRESS 0x41
#endif

void ACC_init () {
  delay(10);
  //default range 2G: 1G = 4096 unit.
  i2c_writeReg(BMA180_ADDRESS,0x0D,1<<4); // register: ctrl_reg0  -- value: set bit ee_w to 1 to enable writing
  delay(5);
  uint8_t control = i2c_readReg(BMA180_ADDRESS, 0x20);
  control = control & 0x0F;        // save tcs register
  //control = control | (0x01 << 4); // register: bw_tcs reg: bits 4-7 to set bw -- value: set low pass filter to 20Hz
  control = control | (0x00 << 4); // set low pass filter to 10Hz (bits value = 0000xxxx)
  i2c_writeReg(BMA180_ADDRESS, 0x20, control);
  delay(5);
  control = i2c_readReg(BMA180_ADDRESS, 0x30);
  control = control & 0xFC;        // save tco_z register
  control = control | 0x00;        // set mode_config to 0
  i2c_writeReg(BMA180_ADDRESS, 0x30, control);
  delay(5);
  control = i2c_readReg(BMA180_ADDRESS, 0x35);
  control = control & 0xF1;        // save offset_x and smp_skip register
  control = control | (0x05 << 1); // set range to 8G
  i2c_writeReg(BMA180_ADDRESS, 0x35, control);
  delay(5);
}

void ACC_getADC () {
  i2c_getSixRawADC(BMA180_ADDRESS,0x02);
  //usefull info is on the 14 bits  [2-15] bits  /4 => [0-13] bits  /4 => 12 bit resolution
  ACC_ORIENTATION((int16_t)((rawADC[1]<<8) | rawADC[0])>>4 ,
    (int16_t)((rawADC[3]<<8) | rawADC[2])>>4 ,
    (int16_t)((rawADC[5]<<8) | rawADC[4])>>4 );
  ACC_Common();
}
#endif

// ************************************************************************************************************
// I2C Accelerometer BMA280
// ************************************************************************************************************
#if defined(BMA280)
#if !defined(BMA280_ADDRESS)
  #define BMA280_ADDRESS 0x18 // SDO PIN on GND
  //#define BMA280_ADDRESS 0x19  // SDO PIN on Vddio
#endif

void ACC_init () {
  delay(10);
  i2c_writeReg(BMA280_ADDRESS, 0x10, 0x09); //set BW to 15,63Hz
  delay(5);
  i2c_writeReg(BMA280_ADDRESS, 0x0F, 0x08); //set range to 8G
}

void ACC_getADC () {
  i2c_getSixRawADC(BMA280_ADDRESS,0x02);
  //usefull info is on the 14 bits  [2-15] bits  /4 => [0-13] bits  /4 => 12 bit resolution
  ACC_ORIENTATION((int16_t)((rawADC[1]<<8) | rawADC[0])>>4 ,
    (int16_t)((rawADC[3]<<8) | rawADC[2])>>4 ,
    (int16_t)((rawADC[5]<<8) | rawADC[4])>>4 );
  ACC_Common();
}
#endif

// ************************************************************************************************************
// I2C Accelerometer BMA020
// ************************************************************************************************************
// I2C adress: 0x70 (8bit)
// Resolution: 10bit
// Control registers:
//
// Datasheet: After power on reset or soft reset it is recommended to set the SPI4-bit to the correct value.
//            0x80 = SPI four-wire = Default setting
// | 0x15: | SPI4 | enable_adv_INT | new_data_INT | latch_INT | shadow_dis | wake_up_pause<1:0> | wake_up |
// |       |    1 |              0 |            0 |         0 |          0 |                 00 |       0 |
//
// | 0x14: |                       reserved <2:0> |            range <1:0> |               bandwith <2:0> |
// |       |                      !!Calibration!! |                     2g |                         25Hz |
//
// ************************************************************************************************************
#if defined(BMA020)
void ACC_init(){
  i2c_writeReg(0x38,0x15,0x80);    // set SPI4 bit
  uint8_t control = i2c_readReg(0x70, 0x14);
  control = control & 0xE0;        // save bits 7,6,5
  control = control | (0x02 << 3); // Range 8G (10)
  control = control | 0x00;        // Bandwidth 25 Hz 000
  i2c_writeReg(0x38,0x14,control);
}

void ACC_getADC(){
  i2c_getSixRawADC(0x38,0x02);
  ACC_ORIENTATION((int16_t)((rawADC[1]<<8) | rawADC[0])>>6 ,
    (int16_t)((rawADC[3]<<8) | rawADC[2])>>6 ,
    (int16_t)((rawADC[5]<<8) | rawADC[4])>>6 );
  ACC_Common();
}
#endif

// ************************************************************************
// LIS3LV02 I2C Accelerometer
// ************************************************************************
#if defined(LIS3LV02)
#define LIS3A  0x1D

void ACC_init(){
  i2c_writeReg(LIS3A ,0x20 ,0xD7 ); // CTRL_REG1   1101 0111 Pwr on, 160Hz
  i2c_writeReg(LIS3A ,0x21 ,0x50 ); // CTRL_REG2   0100 0000 Littl endian, 12 Bit, Boot
}

void ACC_getADC(){
  i2c_getSixRawADC(LIS3A,0x28+0x80);
  ACC_ORIENTATION((int16_t)((rawADC[1]<<8) | rawADC[0])>>2 ,
    (int16_t)((rawADC[3]<<8) | rawADC[2])>>2 ,
    (int16_t)((rawADC[5]<<8) | rawADC[4])>>2);
  ACC_Common();
}
#endif

// ************************************************************************************************************
// I2C Accelerometer LSM303DLx
// ************************************************************************************************************
#if defined(LSM303DLx_ACC)
void ACC_init () {
  delay(10);
  i2c_writeReg(0x18,0x20,0x27);
  i2c_writeReg(0x18,0x23,0x30);
  i2c_writeReg(0x18,0x21,0x00);
}

  void ACC_getADC () {
  i2c_getSixRawADC(0x18,0xA8);

  ACC_ORIENTATION((int16_t)((rawADC[1]<<8) | rawADC[0])>>4 ,
    (int16_t)((rawADC[3]<<8) | rawADC[2])>>4 ,
    (int16_t)((rawADC[5]<<8) | rawADC[4])>>4 );
  ACC_Common();
}
#endif

// ************************************************************************************************************
// ADC ACC
// ************************************************************************************************************
#if defined(ADCACC)
void ACC_init(){
  pinMode(A1,INPUT);
  pinMode(A2,INPUT);
  pinMode(A3,INPUT);
}

void ACC_getADC() {
  ACC_ORIENTATION(  analogRead(A1) ,
                    analogRead(A2) ,
                    analogRead(A3) );
  ACC_Common();
}
#endif

// ************************************************************************************************************
// I2C Gyroscope L3G4200D
// ************************************************************************************************************
#if defined(L3G4200D)
#define L3G4200D_ADDRESS 0x69
void Gyro_init() {
  delay(100);
  i2c_writeReg(L3G4200D_ADDRESS ,0x20 ,0x8F ); // CTRL_REG1   400Hz ODR, 20hz filter, run!
  delay(5);
  i2c_writeReg(L3G4200D_ADDRESS ,0x24 ,0x02 ); // CTRL_REG5   low pass filter enable
  delay(5);
  i2c_writeReg(L3G4200D_ADDRESS ,0x23 ,0x30); // CTRL_REG4 Select 2000dps
}

void Gyro_getADC () {
  i2c_getSixRawADC(L3G4200D_ADDRESS,0x80|0x28);

  GYRO_ORIENTATION((int16_t)((rawADC[1]<<8) | rawADC[0])>>2  ,
    (int16_t)((rawADC[3]<<8) | rawADC[2])>>2  ,
    (int16_t)((rawADC[5]<<8) | rawADC[4])>>2  );
  GYRO_Common();
}
#endif

// ************************************************************************************************************
// I2C Gyroscope ITG3200 / ITG3205 / ITG3050 / MPU3050
// ************************************************************************************************************
// I2C adress: 0xD2 (8bit)   0x69 (7bit)
// I2C adress: 0xD0 (8bit)   0x68 (7bit)
// principle:
// 1) VIO is connected to VDD
// 2) I2C adress is set to 0x69 (AD0 PIN connected to VDD)
// or 2) I2C adress is set to 0x68 (AD0 PIN connected to GND)
// 3) sample rate = 1000Hz ( 1kHz/(div+1) )
// ************************************************************************************************************
#if defined(ITG3200) || defined(ITG3050) || defined(MPU3050)
#if !defined(GYRO_ADDRESS)
  #define GYRO_ADDRESS 0X68
  //#define GYRO_ADDRESS 0X69
#endif

void Gyro_init() {
  i2c_writeReg(GYRO_ADDRESS, 0x3E, 0x80);                 //PWR_MGMT_1    -- DEVICE_RESET 1
  delay(5);
  i2c_writeReg(GYRO_ADDRESS, 0x16, 0x18 + GYRO_DLPF_CFG); //Gyro CONFIG   -- EXT_SYNC_SET 0 (disable input pin for data sync) ; DLPF_CFG = GYRO_DLPF_CFG ; -- FS_SEL = 3: Full scale set to 2000 deg/sec
  delay(5);
  i2c_writeReg(GYRO_ADDRESS, 0x3E, 0x03);                 //PWR_MGMT_1    -- SLEEP 0; CYCLE 0; TEMP_DIS 0; CLKSEL 3 (PLL with Z Gyro reference)
  delay(100);
}

void Gyro_getADC () {
  i2c_getSixRawADC(GYRO_ADDRESS,0X1D);
  GYRO_ORIENTATION((int16_t)((rawADC[0]<<8) | rawADC[1])>>2 , // range: +/- 8192; +/- 2000 deg/sec
    (int16_t)((rawADC[2]<<8) | rawADC[3])>>2 ,
    (int16_t)((rawADC[4]<<8) | rawADC[5])>>2 );
  GYRO_Common();
}
#endif


// ************************************************************************************************************
// I2C Compass common function
// ************************************************************************************************************
#if MAG
static float magGain[3] = {1.0,1.0,1.0};  // gain for each axis, populated at sensor init

uint8_t Mag_getADC() { // return 1 when news values are available, 0 otherwise
	static uint32_t t, tCal = 0;
	static int16_t magZeroTempMin[3], magZeroTempMax[3];
	uint8_t axis;

	if (!f.CALIBRATE_MAG && currentTime < t) {
		return 0; // each read is spaced by 50ms/20hz BUT not during calibration
	}
	t = currentTime + 50000;

	Device_Mag_getADC();

	#define MAG_LPF_FACTOR 10.0f
	static float magADC_filtered[3];

	for (axis = 0; axis < 3; axis++) {
		imu.magADC[axis] = imu.magADC[axis] * magGain[axis];

		if (!f.ARMED) {
			magADC_filtered[axis] = magADC_filtered[axis] * (1.0f - (1.0f / MAG_LPF_FACTOR))
					+ imu.magADC[axis] * (1.0f / MAG_LPF_FACTOR);
		}

		if (!f.CALIBRATE_MAG) {
			imu.magADC[axis] -= global_conf.magZero[axis];
		}
	}

	if (f.CALIBRATE_MAG) {

		if (tCal == 0) {// init mag calibration
			tCal = t;
      magBeep = millis();
		}
		if ((t - tCal) < 30000000) { // 30s: you have 30s to turn drone in all directions
			LEDPIN_TOGGLE;
			for (axis = 0; axis < 3; axis++) {
				if (tCal == t) { // it happens only in the first step, initialize the zero
					magZeroTempMin[axis] = magADC_filtered[axis];
					magZeroTempMax[axis] = magADC_filtered[axis];
				}
				if (((int16_t)magADC_filtered[axis]) < magZeroTempMin[axis]) {
					magZeroTempMin[axis] = magADC_filtered[axis];
					SET_ALARM(ALRM_FAC_TOGGLE, ALRM_LVL_TOGGLE_1);
          magBeep = millis() + 20;
          tCal = max( tCal, (uint32_t)(t - 20000000));  //at least 10 seconds without new max/min
				}
				if (((int16_t)magADC_filtered[axis]) > magZeroTempMax[axis]) {
					magZeroTempMax[axis] = magADC_filtered[axis];
					SET_ALARM(ALRM_FAC_TOGGLE, ALRM_LVL_TOGGLE_1);
          magBeep = millis() + 20;
          tCal = max( tCal, (uint32_t)(t - 20000000));  //at least 10 seconds without new max/min
				}
				global_conf.magZero[axis] = (magZeroTempMin[axis]
						+ magZeroTempMax[axis]) >> 1;
			}
		} else {
			f.CALIBRATE_MAG = 0;
			tCal = 0;
			writeGlobalSet(1);
		}
	}

  #if defined(SENSORS_TILT_45DEG_LEFT)
    int16_t temp = ((imu.magADC[PITCH] - imu.magADC[ROLL] )*7)/10;
    imu.magADC[ROLL] = ((imu.magADC[ROLL]  + imu.magADC[PITCH])*7)/10;
    imu.magADC[PITCH] = temp;
  #endif
  #if defined(SENSORS_TILT_45DEG_RIGHT)
    int16_t temp = ((imu.magADC[PITCH] + imu.magADC[ROLL] )*7)/10;
    imu.magADC[ROLL] = ((imu.magADC[ROLL]  - imu.magADC[PITCH])*7)/10;
    imu.magADC[PITCH] = temp;
  #endif

  return 1;
}
#endif

// ************************************************************************************************************
// I2C Compass MAG3110
// ************************************************************************************************************
// I2C adress: 0x0E (7bit)
// ************************************************************************************************************
#if defined(MAG3110)
#define MAG_ADDRESS 0x0E
#define MAG_DATA_REGISTER 0x01
#define MAG_CTRL_REG1 0x10
#define MAG_CTRL_REG2 0x11

void Mag_init() {
  delay(100);
  i2c_writeReg(MAG_ADDRESS,MAG_CTRL_REG2,0x80);  //Automatic Magnetic Sensor Reset
  delay(100);
  i2c_writeReg(MAG_ADDRESS,MAG_CTRL_REG1,0x11); // DR = 20Hz ; OS ratio = 64 ; mode = Active
  delay(100);
}

#if !defined(MPU6050_I2C_AUX_MASTER)
  void Device_Mag_getADC() {
    i2c_getSixRawADC(MAG_ADDRESS,MAG_DATA_REGISTER);
    MAG_ORIENTATION((int16_t)((rawADC[0]<<8) | rawADC[1]) ,
      (int16_t)((rawADC[2]<<8) | rawADC[3]) ,
      (int16_t)((rawADC[4]<<8) | rawADC[5]) );
  }
#endif
#endif


// ************************************************************************************************************
// I2C Compass HMC5883
// ************************************************************************************************************
// I2C adress: 0x3C (8bit)   0x1E (7bit)
// ************************************************************************************************************

#if defined(HMC5883)

#define HMC58X3_R_CONFA 0
#define HMC58X3_R_CONFB 1
#define HMC58X3_R_MODE 2
#define HMC58X3_X_SELF_TEST_GAUSS (+1.16)                       //!< X axis level when bias current is applied.
#define HMC58X3_Y_SELF_TEST_GAUSS (+1.16)   //!< Y axis level when bias current is applied.
#define HMC58X3_Z_SELF_TEST_GAUSS (+1.08)                       //!< Y axis level when bias current is applied.
#define SELF_TEST_LOW_LIMIT  (243.0/390.0)   //!< Low limit when gain is 5.
#define SELF_TEST_HIGH_LIMIT (575.0/390.0)   //!< High limit when gain is 5.
#define HMC_POS_BIAS 1
#define HMC_NEG_BIAS 2

#define MAG_ADDRESS 0x1E
#define MAG_DATA_REGISTER 0x03

static int32_t xyz_total[3]={0,0,0};  // 32 bit totals so they won't overflow.

static void getADC() {
  i2c_getSixRawADC(MAG_ADDRESS,MAG_DATA_REGISTER);
  MAG_ORIENTATION((int16_t)((rawADC[0]<<8) | rawADC[1]) ,
    (int16_t)((rawADC[4]<<8) | rawADC[5]) ,
    (int16_t)((rawADC[2]<<8) | rawADC[3]) );
}

static uint8_t bias_collect(uint8_t bias) {
  int16_t abs_magADC;

  i2c_writeReg(MAG_ADDRESS, HMC58X3_R_CONFA, bias);            // Reg A DOR=0x010 + MS1,MS0 set to pos or negative bias
  for (uint8_t i=0; i<10; i++) {                               // Collect 10 samples
    i2c_writeReg(MAG_ADDRESS,HMC58X3_R_MODE, 1);
    delay(100);
    getADC();                                                  // Get the raw values in case the scales have already been changed.
    for (uint8_t axis=0; axis<3; axis++) {
      abs_magADC =  abs(imu.magADC[axis]);
      xyz_total[axis]+= abs_magADC;                            // Since the measurements are noisy, they should be averaged rather than taking the max.
      if ((int16_t)(1<<12) < abs_magADC) return false;         // Detect saturation.   if false Breaks out of the for loop.  No sense in continuing if we saturated.
    }
  }
  return true;
}

static void Mag_init() {
  bool bret=true;                // Error indicator

  // Note that the  very first measurement after a gain change maintains the same gain as the previous setting.
  // The new gain setting is effective from the second measurement and on.
  i2c_writeReg(MAG_ADDRESS, HMC58X3_R_CONFB, 2 << 5);  //Set the Gain
  i2c_writeReg(MAG_ADDRESS,HMC58X3_R_MODE, 1);
  delay(100);
  getADC();  //Get one sample, and discard it

  if (!bias_collect(0x010 + HMC_POS_BIAS)) bret = false;
  if (!bias_collect(0x010 + HMC_NEG_BIAS)) bret = false;

  if (bret) // only if no saturation detected, compute the gain. otherwise, the default 1.0 is used
    for (uint8_t axis=0; axis<3; axis++)
      magGain[axis]=820.0*HMC58X3_X_SELF_TEST_GAUSS*2.0*10.0/xyz_total[axis];  // note: xyz_total[axis] is always positive

  // leave test mode
  i2c_writeReg(MAG_ADDRESS ,HMC58X3_R_CONFA ,0x70 ); //Configuration Register A  -- 0 11 100 00  num samples: 8 ; output rate: 15Hz ; normal measurement mode
  i2c_writeReg(MAG_ADDRESS ,HMC58X3_R_CONFB ,0x20 ); //Configuration Register B  -- 001 00000    configuration gain 1.3Ga
  i2c_writeReg(MAG_ADDRESS ,HMC58X3_R_MODE  ,0x00 ); //Mode register             -- 000000 00    continuous Conversion Mode
  delay(100);
}

#if !defined(MPU6050_I2C_AUX_MASTER)
static void Device_Mag_getADC() {
  getADC();
}
#endif
#endif

// ************************************************************************************************************
// I2C Compass QMC5883L
// ************************************************************************************************************
// I2C adress: 0x0D (7bit)
// ************************************************************************************************************
#if defined(QMC5883)

#define MAG_ADDRESS 0x0D
#define MAG_DATA_REGISTER 0x00

//REG CONTROL
#define MAG_CTRL_REG1 0x09
#define QMC_MODE 0xC1 // 11 00 00 01OSR=64(11); Range=2G(00); ODR=10Hz(00); MODE=Cont(01)
#define MAG_CTRL_REG2 0x0A

void Mag_init()
{
  i2c_writeReg(MAG_ADDRESS, 0x0B, 0x01);
  i2c_writeReg(MAG_ADDRESS, MAG_CTRL_REG1, QMC_MODE);
}


static void getADC()
{
  i2c_getSixRawADC(MAG_ADDRESS, MAG_DATA_REGISTER);
  MAG_ORIENTATION((int16_t)((rawADC[1] << 8) | rawADC[0]),
    (int16_t)((rawADC[3] << 8) | rawADC[2]),
    (int16_t)((rawADC[5] << 8) | rawADC[4]));
}

#if !defined(MPU6050_I2C_AUX_MASTER)
static void Device_Mag_getADC()
{
  getADC();
}
#endif
#endif

// ************************************************************************************************************
// I2C Compass HMC5843
// ************************************************************************************************************
// I2C adress: 0x3C (8bit)   0x1E (7bit)
// ************************************************************************************************************
#if defined(HMC5843)
#define MAG_ADDRESS 0x1E
#define MAG_DATA_REGISTER 0x03

void getADC() {
  i2c_getSixRawADC(MAG_ADDRESS,MAG_DATA_REGISTER);
  MAG_ORIENTATION((int16_t)((rawADC[0]<<8) | rawADC[1]) ,
    (int16_t)((rawADC[2]<<8) | rawADC[3]) ,
    (int16_t)((rawADC[4]<<8) | rawADC[5]) );
}

void Mag_init() {
  delay(100);
  // force positiveBias
  i2c_writeReg(MAG_ADDRESS ,0x00 ,0x71 ); //Configuration Register A  -- 0 11 100 01  num samples: 8 ; output rate: 15Hz ; positive bias
  delay(50);
  // set gains for calibration
  i2c_writeReg(MAG_ADDRESS ,0x01 ,0x60 ); //Configuration Register B  -- 011 00000    configuration gain 2.5Ga
  i2c_writeReg(MAG_ADDRESS ,0x02 ,0x01 ); //Mode register             -- 000000 01    single Conversion Mode

  // read values from the compass -  self test operation
  // by placing the mode register into single-measurement mode (0x01), two data acquisition cycles will be made on each magnetic vector.
  // The first acquisition values will be subtracted from the second acquisition, and the net measurement will be placed into the data output registers
  delay(100);
  getADC();
  delay(10);
  magGain[ROLL]  =  1000.0 / abs(imu.magADC[ROLL]);
  magGain[PITCH] =  1000.0 / abs(imu.magADC[PITCH]);
  magGain[YAW]   =  1000.0 / abs(imu.magADC[YAW]);

  // leave test mode
  i2c_writeReg(MAG_ADDRESS ,0x00 ,0x70 ); //Configuration Register A  -- 0 11 100 00  num samples: 8 ; output rate: 15Hz ; normal measurement mode
  i2c_writeReg(MAG_ADDRESS ,0x01 ,0x20 ); //Configuration Register B  -- 001 00000    configuration gain 1.3Ga
  i2c_writeReg(MAG_ADDRESS ,0x02 ,0x00 ); //Mode register             -- 000000 00    continuous Conversion Mode
}

#if !defined(MPU6050_I2C_AUX_MASTER)
void Device_Mag_getADC() {
  getADC();
}
#endif
#endif


// ************************************************************************************************************
// I2C Compass AK8975
// ************************************************************************************************************
// I2C adress: 0x0C (7bit)
// ************************************************************************************************************
#if defined(AK8975)
  #define MAG_ADDRESS 0x0C
  #define MAG_DATA_REGISTER 0x03

  void Mag_init() {
    delay(100);
    i2c_writeReg(MAG_ADDRESS,0x0a,0x01);  //Start the first conversion
    delay(100);
  }

  void Device_Mag_getADC() {
    i2c_getSixRawADC(MAG_ADDRESS,MAG_DATA_REGISTER);
    MAG_ORIENTATION((int16_t)((rawADC[1]<<8) | rawADC[0]) ,
      (int16_t)((rawADC[3]<<8) | rawADC[2]) ,
      (int16_t)((rawADC[5]<<8) | rawADC[4]) );
    //Start another meassurement
    i2c_writeReg(MAG_ADDRESS,0x0a,0x01);
  }
#endif

// ************************************************************************************************************
// I2C Gyroscope and Accelerometer MPU6050
// ************************************************************************************************************
#if defined(MPU6050)
#if !defined(MPU6050_ADDRESS)
  #define MPU6050_ADDRESS     0x68 // address pin AD0 low (GND), default for FreeIMU v0.4 and InvenSense evaluation board
  //#define MPU6050_ADDRESS     0x69 // address pin AD0 high (VCC)
#endif

static void Gyro_init() {
  i2c_writeReg(MPU6050_ADDRESS, 0x6B, 0x80);             //PWR_MGMT_1    -- DEVICE_RESET 1
  delay(50);
  i2c_writeReg(MPU6050_ADDRESS, 0x6B, 0x03);             //PWR_MGMT_1    -- SLEEP 0; CYCLE 0; TEMP_DIS 0; CLKSEL 3 (PLL with Z Gyro reference)
  i2c_writeReg(MPU6050_ADDRESS, 0x1A, GYRO_DLPF_CFG);    //CONFIG        -- EXT_SYNC_SET 0 (disable input pin for data sync) ; default DLPF_CFG = 0 => ACC bandwidth = 260Hz  GYRO bandwidth = 256Hz)
  i2c_writeReg(MPU6050_ADDRESS, 0x1B, 0x18);             //GYRO_CONFIG   -- FS_SEL = 3: Full scale set to 2000 deg/sec
  // enable I2C bypass for AUX I2C
  #if defined(MAG)
    i2c_writeReg(MPU6050_ADDRESS, 0x37, 0x02);           //INT_PIN_CFG   -- INT_LEVEL=0 ; INT_OPEN=0 ; LATCH_INT_EN=0 ; INT_RD_CLEAR=0 ; FSYNC_INT_LEVEL=0 ; FSYNC_INT_EN=0 ; I2C_BYPASS_EN=1 ; CLKOUT_EN=0
  #endif
}

void Gyro_getADC () {
  i2c_getSixRawADC(MPU6050_ADDRESS, 0x43);
  //REVIEW: should not shift negative numbers, especially right!
  GYRO_ORIENTATION( (int16_t)((rawADC[0]<<8) | rawADC[1])>>2 , // range: +/- 8192; +/- 2000 deg/sec
    (int16_t)((rawADC[2]<<8) | rawADC[3])>>2 ,
    (int16_t)((rawADC[4]<<8) | rawADC[5])>>2 );

  //imu.gyroADC[ROLL] = 0; imu.gyroADC[PITCH] = 0; imu.gyroADC[YAW] = 0;

  /*
  Serial.print(imu.gyroADC[ROLL]); Serial.print("\t");
  Serial.print(imu.gyroADC[PITCH]); Serial.print("\t");
  Serial.print(imu.gyroADC[YAW]); Serial.println("\t");
  */

  GYRO_Common();
}

static void ACC_init () {
  i2c_writeReg(MPU6050_ADDRESS, 0x1C, 0x10);             //ACCEL_CONFIG  -- AFS_SEL=2 (Full Scale = +/-8G)  ; ACCELL_HPF=0   //note something is wrong in the spec.
  //note: something seems to be wrong in the spec here. With AFS=2 1G = 4096 but according to my measurement: 1G=2048 (and 2048/8 = 256)
  //confirmed here: http://www.multiwii.com/forum/viewtopic.php?f=8&t=1080&start=10#p7480

  #if defined(MPU6050_I2C_AUX_MASTER)
    //at this stage, the MAG is configured via the original MAG init function in I2C bypass mode
    //now we configure MPU as a I2C Master device to handle the MAG via the I2C AUX port (done here for HMC5883)
    i2c_writeReg(MPU6050_ADDRESS, 0x6A, 0b00100000);       //USER_CTRL     -- DMP_EN=0 ; FIFO_EN=0 ; I2C_MST_EN=1 (I2C master mode) ; I2C_IF_DIS=0 ; FIFO_RESET=0 ; I2C_MST_RESET=0 ; SIG_COND_RESET=0
    i2c_writeReg(MPU6050_ADDRESS, 0x37, 0x00);             //INT_PIN_CFG   -- INT_LEVEL=0 ; INT_OPEN=0 ; LATCH_INT_EN=0 ; INT_RD_CLEAR=0 ; FSYNC_INT_LEVEL=0 ; FSYNC_INT_EN=0 ; I2C_BYPASS_EN=0 ; CLKOUT_EN=0
    i2c_writeReg(MPU6050_ADDRESS, 0x24, 0x0D);             //I2C_MST_CTRL  -- MULT_MST_EN=0 ; WAIT_FOR_ES=0 ; SLV_3_FIFO_EN=0 ; I2C_MST_P_NSR=0 ; I2C_MST_CLK=13 (I2C slave speed bus = 400kHz)
    i2c_writeReg(MPU6050_ADDRESS, 0x25, 0x80|MAG_ADDRESS);//I2C_SLV0_ADDR -- I2C_SLV4_RW=1 (read operation) ; I2C_SLV4_ADDR=MAG_ADDRESS
    i2c_writeReg(MPU6050_ADDRESS, 0x26, MAG_DATA_REGISTER);//I2C_SLV0_REG  -- 6 data bytes of MAG are stored in 6 registers. First register address is MAG_DATA_REGISTER
    i2c_writeReg(MPU6050_ADDRESS, 0x27, 0x86);             //I2C_SLV0_CTRL -- I2C_SLV0_EN=1 ; I2C_SLV0_BYTE_SW=0 ; I2C_SLV0_REG_DIS=0 ; I2C_SLV0_GRP=0 ; I2C_SLV0_LEN=3 (3x2 bytes)
  #endif
}

void ACC_getADC () {
  i2c_getSixRawADC(MPU6050_ADDRESS, 0x3B);
  //TODO: should not shift negative numbers, especially right!
  ACC_ORIENTATION( (int16_t)((rawADC[0]<<8) | rawADC[1])>>3 ,
    (int16_t)((rawADC[2]<<8) | rawADC[3])>>3 ,
    (int16_t)((rawADC[4]<<8) | rawADC[5])>>3 );


  /*
  Serial.print(imu.accADC[ROLL]); Serial.print("\t");
  Serial.print(imu.accADC[PITCH]); Serial.print("\t");
  Serial.print(imu.accADC[YAW]); Serial.println("\t");
  */

  ACC_Common();
}

//The MAG acquisition function must be replaced because we now talk to the MPU device
  #if defined(MPU6050_I2C_AUX_MASTER)
    static void Device_Mag_getADC() {
      i2c_getSixRawADC(MPU6050_ADDRESS, 0x49);               //0x49 is the first memory room for EXT_SENS_DATA
      #if defined(HMC5843)
        MAG_ORIENTATION( (int16_t)((rawADC[0]<<8) | rawADC[1]) ,
                          (int16_t)((rawADC[2]<<8) | rawADC[3]) ,
                          (int16_t)((rawADC[4]<<8) | rawADC[5]) );
      #endif
      #if defined (HMC5883)
        MAG_ORIENTATION((int16_t)((rawADC[0]<<8) | rawADC[1]) ,
          (int16_t)((rawADC[4]<<8) | rawADC[5]) ,
          (int16_t)((rawADC[2]<<8) | rawADC[3]) );
      #endif
      #if defined (MAG3110)
        MAG_ORIENTATION((int16_t)((rawADC[0]<<8) | rawADC[1]) ,
          (int16_t)((rawADC[2]<<8) | rawADC[3]) ,
          (int16_t)((rawADC[4]<<8) | rawADC[5]) );
      #endif

      #if defined(QMC5883)
        MAG_ORIENTATION((int16_t)((rawADC[1] << 8) | rawADC[0]),
          (int16_t)((rawADC[3] << 8) | rawADC[2]),
          (int16_t)((rawADC[5] << 8) | rawADC[4]));
      #endif
    }
  #endif
#endif

// ************************************************************************************************************
// Start Of I2C Gyroscope and Accelerometer LSM330
// ************************************************************************************************************
#if defined(LSM330)
#if !defined(LSM330_ACC_ADDRESS)
  #define LSM330_ACC_ADDRESS     0x18 // 30 >> 1 = 18  -> address pin SDO_A low (GND)
  //#define LSM330_ACC_ADDRESS     0x19 // 32 >> 1 = 19  -> address pin SDO_A high (VCC)
#endif
#if !defined(LSM330_GYRO_ADDRESS)
  #define LSM330_GYRO_ADDRESS     0x6A // D4 >> 1 = 6A  -> address pin SDO_G low (GND)
  //#define LSM330_GYRO_ADDRESS     0x6B // D6 >> 1 = 6B  -> address pin SDO_G high (VCC)
#endif

////////////////////////////////////
//           ACC start            //
////////////////////////////////////
void ACC_init () {

  delay(10);
  //i2c_writeReg(LSM330_ACC_ADDRESS ,0x20 ,0x17 ); // 1Hz
  //i2c_writeReg(LSM330_ACC_ADDRESS ,0x20 ,0x27 ); // 10Hz
  i2c_writeReg(LSM330_ACC_ADDRESS ,0x20 ,0x37 );  // 25Hz
  //i2c_writeReg(LSM330_ACC_ADDRESS ,0x20 ,0x47 ); // 50Hz
  //i2c_writeReg(LSM330_ACC_ADDRESS ,0x20 ,0x57 ); // 100Hz

  delay(5);
  //i2c_writeReg(LSM330_ACC_ADDRESS ,0x23 ,0x08 ); // 2G
  //i2c_writeReg(LSM330_ACC_ADDRESS ,0x23 ,0x18 ); // 4G
  i2c_writeReg(LSM330_ACC_ADDRESS ,0x23 ,0x28 ); // 8G
  //i2c_writeReg(LSM330_ACC_ADDRESS ,0x23 ,0x38 ); // 16G

  delay(5);
  i2c_writeReg(LSM330_ACC_ADDRESS,0x21,0x00);// no high-pass filter
}

//#define ACC_DELIMITER 5 // for 2g
#define ACC_DELIMITER 4 // for 4g
//#define ACC_DELIMITER 3 // for 8g
//#define ACC_DELIMITER 2 // for 16g

  void ACC_getADC () {
  i2c_getSixRawADC(LSM330_ACC_ADDRESS,0x80|0x28);// Start multiple read at reg 0x28

  ACC_ORIENTATION((int16_t)((rawADC[1]<<8) | rawADC[0])>>ACC_DELIMITER ,
    (int16_t)((rawADC[3]<<8) | rawADC[2])>>ACC_DELIMITER ,
    (int16_t)((rawADC[5]<<8) | rawADC[4])>>ACC_DELIMITER );
  ACC_Common();
}
////////////////////////////////////
//            ACC end             //
////////////////////////////////////

////////////////////////////////////
//           Gyro start           //
////////////////////////////////////
void Gyro_init() {
  delay(100);
  i2c_writeReg(LSM330_GYRO_ADDRESS ,0x20 ,0x8F ); // CTRL_REG1   400Hz ODR, 20hz filter, run!
  delay(5);
  i2c_writeReg(LSM330_GYRO_ADDRESS ,0x24 ,0x02 ); // CTRL_REG5   low pass filter enable
  delay(5);
  i2c_writeReg(LSM330_GYRO_ADDRESS ,0x23 ,0x30);  // CTRL_REG4 Select 2000dps
}

void Gyro_getADC () {
  i2c_getSixRawADC(LSM330_GYRO_ADDRESS,0x80|0x28);

  GYRO_ORIENTATION( (int16_t)((rawADC[1]<<8) | rawADC[0])>>2  ,
    (int16_t)((rawADC[3]<<8) | rawADC[2])>>2  ,
    (int16_t)((rawADC[5]<<8) | rawADC[4])>>2  );
  GYRO_Common();
}
////////////////////////////////////
//            Gyro end            //
////////////////////////////////////

#endif /* LSM330 */

// ************************************************************************************************************
// End Of I2C Gyroscope and Accelerometer LSM330
// ************************************************************************************************************


#if defined(WMP)
// ************************************************************************************************************
// I2C Wii Motion Plus
// ************************************************************************************************************
// I2C adress 1: 0x53 (7bit)
// I2C adress 2: 0x52 (7bit)
// ************************************************************************************************************
#define WMP_ADDRESS_1 0x53
#define WMP_ADDRESS_2 0x52

void Gyro_init() {
  delay(250);
  i2c_writeReg(WMP_ADDRESS_1, 0xF0, 0x55); // Initialize Extension
  delay(250);
  i2c_writeReg(WMP_ADDRESS_1, 0xFE, 0x05); // Activate Nunchuck pass-through mode
  delay(250);
}

void Gyro_getADC() {
  uint8_t axis;
  TWBR = ((F_CPU / I2C_SPEED) - 16) / 2; // change the I2C clock rate
  i2c_getSixRawADC(WMP_ADDRESS_2,0x00);
  TWBR = ((F_CPU / 400000) - 16) / 2; // change the I2C clock rate.

  if (micros() < (neutralizeTime + NEUTRALIZE_DELAY)) {//we neutralize data in case of blocking+hard reset state
    for (axis = 0; axis < 3; axis++) {imu.gyroADC[axis]=0;imu.accADC[axis]=0;}
    imu.accADC[YAW] = ACC_1G;
  }

  // Wii Motion Plus Data
  if ( (rawADC[5]&0x03) == 0x02 ) {
    // Assemble 14bit data
    imu.gyroADC[ROLL]  = - ( ((rawADC[5]>>2)<<8) | rawADC[2] ); //range: +/- 8192
    imu.gyroADC[PITCH] = - ( ((rawADC[4]>>2)<<8) | rawADC[1] );
    imu.gyroADC[YAW]  =  - ( ((rawADC[3]>>2)<<8) | rawADC[0] );
    GYRO_Common();
    // Check if slow bit is set and normalize to fast mode range
    imu.gyroADC[ROLL]  = (rawADC[3]&0x01)     ? imu.gyroADC[ROLL]/5  : imu.gyroADC[ROLL];  //the ratio 1/5 is not exactly the IDG600 or ISZ650 specification
    imu.gyroADC[PITCH] = (rawADC[4]&0x02)>>1  ? imu.gyroADC[PITCH]/5 : imu.gyroADC[PITCH]; //we detect here the slow of fast mode WMP gyros values (see wiibrew for more details)
    imu.gyroADC[YAW]   = (rawADC[3]&0x02)>>1  ? imu.gyroADC[YAW]/5   : imu.gyroADC[YAW];   // this step must be done after zero compensation
  }
}
#endif


// ************************************************************************************************************
// I2C Sonar SRF08
// ************************************************************************************************************
// first contribution from guru_florida (02-25-2012)
//
#if defined(SRF02) || defined(SRF08) || defined(SRF10) || defined(SRC235)

// the default address for any new sensor found on the bus
// the code will move new sonars to the next available sonar address in range of F0-FE so that another
// sonar sensor can be added again.
// Thus, add only 1 sonar sensor at a time, poweroff, then wire the next, power on, wait for flashing light and repeat
#if !defined(SRF08_DEFAULT_ADDRESS)
  #define SRF08_DEFAULT_ADDRESS (0xE0>>1)
#endif

#if !defined(SRF08_RANGE_WAIT)
  #define SRF08_RANGE_WAIT      70000      // delay between Ping and Range Read commands (65ms is safe in any case)
#endif

#if !defined(SRF08_RANGE_SLEEP)
  #define SRF08_RANGE_SLEEP     5000       // sleep this long before starting another Ping
#endif

#if !defined(SRF08_SENSOR_FIRST)
  #define SRF08_SENSOR_FIRST    (0xF0>>1)  // the first sensor i2c address (after it has been moved)
#endif

#if !defined(SRF08_MAX_SENSORS)
  #define SRF08_MAX_SENSORS     4          // maximum number of sensors we'll allow (can go up to 8)
#endif

//#define SONAR_MULTICAST_PING

// registers of the device
#define SRF08_REV_COMMAND    0
#define SRF08_LIGHT_GAIN     1
#define SRF08_ECHO_RANGE     2


static struct {
  // sensor registers from the MS561101BA datasheet
  int32_t  range[SRF08_MAX_SENSORS];
  int8_t   sensors;              // the number of sensors present
  int8_t   current;              // the current sensor being read
  uint8_t  state;
  uint32_t deadline;
} srf08_ctx;


// read uncompensated temperature value: send command first
void Sonar_init() {
  memset(&srf08_ctx, 0, sizeof(srf08_ctx));
  srf08_ctx.deadline = 4000000;
}

// this function works like readReg accept a failed read is a normal expectation
// use for testing the existence of sensors on the i2c bus
// a 0xffff code is returned if the read failed
uint16_t i2c_try_readReg(uint8_t add, uint8_t reg) {
  uint16_t count = 255;
  i2c_rep_start(add<<1);  // I2C write direction
  i2c_write(reg);        // register selection
  i2c_rep_start((add<<1)|1);  // I2C read direction
  TWCR = (1<<TWINT) | (1<<TWEN);
  while (!(TWCR & (1<<TWINT))) {
    count--;
    if (count==0) {              //we are in a blocking state => we don't insist
      TWCR = 0;                  //and we force a reset on TWINT register
      return 0xffff;  // return failure to read
    }
  }
  uint8_t r = TWDR;
  i2c_stop();
  return r;
}

// read a 16bit unsigned int from the i2c bus
uint16_t i2c_readReg16(int8_t addr, int8_t reg) {
  uint8_t b[2];
  i2c_read_reg_to_buf(addr, reg, (uint8_t*)&b, sizeof(b));
  return (b[0]<<8) | b[1];
}

void i2c_srf08_change_addr(int8_t current, int8_t moveto) {
  // to change a srf08 address, we must write the following sequence to the command register
  // this sequence must occur as 4 seperate i2c transactions!!   A0 AA A5 [addr]
  i2c_writeReg(current, SRF08_REV_COMMAND, 0xA0);    delay(30);
  i2c_writeReg(current, SRF08_REV_COMMAND, 0xAA);    delay(30);
  i2c_writeReg(current, SRF08_REV_COMMAND, 0xA5);    delay(30);
  i2c_writeReg(current, SRF08_REV_COMMAND, moveto);  delay(30); // now change i2c address
}

// discover previously known sensors and any new sensor (move new sensors to assigned area)
void i2c_srf08_discover() {
  uint8_t addr;
  uint16_t x;

  srf08_ctx.sensors=0;                                     // determine how many sensors are plugged in
  addr = SRF08_SENSOR_FIRST;                               // using the I2C address range we choose, starting with first one
  for(uint8_t i=0; i<SRF08_MAX_SENSORS && x!=0xff; i++) {  // 0xff means a mesure is currently running, so try again
    x = i2c_try_readReg(addr, SRF08_REV_COMMAND);          // read the revision as a way to check if sensor exists at this location
    if(x!=0xffff) {                                        // detected a sensor at this address
      i2c_writeReg(addr, SRF08_LIGHT_GAIN, 0x15);          // not set to max to avoid bad echo indoor
      i2c_writeReg(addr, SRF08_ECHO_RANGE, 46);            // set to 2m max
      srf08_ctx.sensors++;
      addr += 1;                                           // 7 bit address => +1 is +2 for 8 bit address
    }
  }
  if(srf08_ctx.sensors < SRF08_MAX_SENSORS) {                 // do not add sensors if we are already maxed
    // now determine if any sensor is on the 'new sensor' address (srf08 default address)
    x = i2c_try_readReg(SRF08_DEFAULT_ADDRESS, SRF08_REV_COMMAND); // we try to read the revision number
    if(x!=0xffff) {                                           // new sensor detected at SRF08 default address
      i2c_srf08_change_addr(SRF08_DEFAULT_ADDRESS, addr<<1);  // move sensor to the next address (8 bit format expected by the device)
      srf08_ctx.sensors++;
    }
  }
}

void Sonar_update() {
  if ((int32_t)(currentTime - srf08_ctx.deadline)<0) return;
  srf08_ctx.deadline = currentTime;
  switch (srf08_ctx.state) {
    case 0:
      i2c_srf08_discover();
      if(srf08_ctx.sensors>0) srf08_ctx.state++;
      else                    srf08_ctx.deadline += 5000000; // wait 5 secs before trying search again
      break;
    case 1:
      srf08_ctx.current=0;
      srf08_ctx.state++;
      srf08_ctx.deadline += SRF08_RANGE_SLEEP;
      break;
    #if defined(SONAR_MULTICAST_PING)
    case 2:
      // send a ping via the general broadcast address
      i2c_writeReg(0, SRF08_REV_COMMAND, 0x51);  // start ranging, result in centimeters
      srf08_ctx.state++;
      srf08_ctx.deadline += SRF08_RANGE_WAIT;
      break;
    case 3:
      srf08_ctx.range[srf08_ctx.current] = i2c_readReg16( SRF08_SENSOR_FIRST+srf08_ctx.current, SRF08_ECHO_RANGE);
      srf08_ctx.current++;
      if(srf08_ctx.current >= srf08_ctx.sensors) srf08_ctx.state=1;
      break;
    #else
    case 2:
      // send a ping to the current sensor
      i2c_writeReg(SRF08_SENSOR_FIRST+srf08_ctx.current, SRF08_REV_COMMAND, 0x51);  // start ranging, result in centimeters
      srf08_ctx.state++;
      srf08_ctx.deadline += SRF08_RANGE_WAIT;
      break;
    case 3:
      srf08_ctx.range[srf08_ctx.current] = i2c_readReg16(SRF08_SENSOR_FIRST+srf08_ctx.current, SRF08_ECHO_RANGE);
      srf08_ctx.current++;
      if(srf08_ctx.current >= srf08_ctx.sensors) srf08_ctx.state=1;
      else                                       srf08_ctx.state=2;
      break;
    #endif
  }
  sonarAlt = srf08_ctx.range[0]; // only one sensor considered for the moment
}
#else
inline void Sonar_init() {}
void Sonar_update() {}
#endif


void initS() {
  i2c_init();
  if (GYRO)  Gyro_init();
  if (BARO)  Baro_init();
  if (MAG)   Mag_init();
  if (ACC)   ACC_init();
  if (SONAR) Sonar_init();
}

void initSensors() {
  uint8_t c = 5;
  #if !defined(DISABLE_POWER_PIN)
    POWERPIN_ON;
    delay(200);
  #endif
  while(c) { // We try several times to init all sensors without any i2c errors. An I2C error at this stage might results in a wrong sensor settings
    c--;
    initS();
    if (i2c_errors_count == 0) break; // no error during init => init ok
  }
}
