RomanLut/Multiwii-ESP32-port/PlatformIO/src/AltHold.cpp

#include "Arduino.h"
#include "config.h"
#include "def.h"
#include "types.h"
#include "MahoWii.h"
#include "AltHold.h"

#if BARO

#define ALT_HOLD_CONTROL_UPDATE_RATE   50		// 50hz update rate

extern int16_t fwAltPID[4] = { 0,0,0,0 };

int32_t altToHold; // in cm
int16_t hoveringThrottle = 0;
int32_t targetVario = 0;
bool takeOffInProgress = false;

bool applyAltHoldControl() {

	static dtimer_t altHoldControlTimer;

    if (updateTimer(&altHoldControlTimer, HZ2US(ALT_HOLD_CONTROL_UPDATE_RATE))) {

    	//debug[3] = altHoldControlTimer.dTime/10;

    	static bool isBaroModeActivated = false;
		static bool isHoveringState = false;

		if ((f.BARO_MODE
				#if GPS
					|| f.GPS_BARO_MODE
				#endif
				) && f.ARMED) {
      // executed in AltHold Mode

			if (!isBaroModeActivated) { //executed on entering AltHold mode
				isBaroModeActivated = true;
				isHoveringState = false;
				takeOffInProgress = false;

				initHoveringThrottle();
				resetLandDetector();

        altToHold = alt.estAlt;
      }

			runLandDetector();

	#if GPS
			if (f.GPS_BARO_MODE) { //executed in navigation modes 

				if (takeOffInProgress) {
					takeOffInProgress = false;
				}

				if (	   NAV_state == NAV_STATE_LAND_IN_PROGRESS
						|| NAV_state == NAV_STATE_LAND_DETECTED
						|| NAV_state == NAV_STATE_LANDED) {

					if (isHoveringState) {
						isHoveringState = false;
					}

					setAltToHold(alt.estAlt); // for safety, e.g. if NAV_state jump to NAV_STATE_NONE when numSat dropped below 4 during navigation

					targetVario = constrain(GPS_conf.min_nav_vario, 30, 100);
					if (alt.estAlt > SAFE_NAV_ALTITUDE) {
						targetVario += (int32_t)(MAX_NAV_VARIO - GPS_conf.min_nav_vario)
								* (alt.estAlt - SAFE_NAV_ALTITUDE) / (GPS_conf.rth_altitude*100 - SAFE_NAV_ALTITUDE);
					}
					targetVario = -targetVario; // for landing target vario is negative
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
