RomanLut/Multiwii-ESP32-port/(commit log)

2021-06-07 VisualMicro project setup ESP32 port bug fixes added blackbox (Cleanflight format) added PS3 controller rx added ftp server implemented serial bluetooth for EZGUI
    [AltHold.cpp, AltHold.h, GPS.cpp, GPS.h, IMU.cpp, INS.cpp, LCD.cpp, MahoWii.cpp]
2021-06-07 switched to PlatformIO
2021-08-08 added simple telemetry added prototypes documentation
2021-08-09 disarm with any throttle value
2021-08-12 fixed landing on failsafe
    [RX.cpp]
2021-08-13 sticky battery alarm
2021-08-13 fixed sticky battery alarm
    [Alarms.cpp]
2021-08-13 added calibration indication
2021-08-21 enhanced magnetometer calibration
2021-11-29 disabled GPS and magnetometer
2022-02-08 updated wiring
2022-08-13 added drawings
    [Bottom.STL, camera_aio.SLDPRT, camera_bottom.SLDPRT, camera_bottom.STL, inset.SLDPRT, inset.STL, ledcap.SLDPRT, ledcap.STL]
2022-08-13 renamed files
    [Bottom.STL, camera_aio.SLDPRT, camera_bottom.SLDPRT, camera_bottom.STL, inset.SLDPRT, inset.STL, ledcap.SLDPRT, ledcap.STL]
